DimaFantasy/LPP/(list of files, drawings)

Other design files:
PCB/LPP_Carriage_Module_Gen_1 Ver_2.dip
PCB/LPP_Carriage_Module_Gen_1_Ver_2.dch
PCB/LPP_MainBoard_Gen_1_Ver_5.dch
PCB/LPP_MainBoard_Gen_1_Ver_5.dip
