DimaFantasy/LPP/LPP_STM32F103C8Tx/Core/Src/main.c

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
/* Includes ------------------------------------------------------------------*/
#include "main.h"
#include "usb_device.h"

/* USER CODE BEGIN Includes */
#include <math.h>
#include <stdbool.h>
#include "counter.h"
#include "stdio.h"

#include "lpp_sdk.h"
/* USER CODE END Includes */

/* USER CODE BEGIN PM */

// ============================================================================
// Сигнатура и версия прошивки (APP)
// ============================================================================
const uint32_t APP_KEY0   __attribute__((section(APP_KEY0_SECTION)))   = APP_SIG_KEY0;
const uint32_t APP_KEY1   __attribute__((section(APP_KEY1_SECTION)))   = APP_SIG_KEY1;
const uint32_t APP_KEY2   __attribute__((section(APP_KEY2_SECTION)))   = APP_SIG_KEY2;
const uint32_t APP_KEY3   __attribute__((section(APP_KEY3_SECTION)))   = APP_SIG_KEY3;

const uint32_t APP_VER_F  __attribute__((section(APP_VER_F_SECTION)))  = APP_VERSION;

// Глобальные определения таймеров и режимов
TIM_HandleTypeDef htim1;
TIM_HandleTypeDef htim2;

/* USER CODE END PM */

TIM_HandleTypeDef htim3;
TIM_HandleTypeDef htim4;

/* USER CODE BEGIN PV */

void XferCpltCallback(DMA_HandleTypeDef *hdma);

// ============================================================================
// Внешние объявления
// ============================================================================

extern uint8_t USBD_CUSTOM_HID_SendReport(USBD_HandleTypeDef* pdev, uint8_t* report, uint16_t len);
extern USBD_HandleTypeDef hUsbDeviceFS;

/* USER CODE END PV */

void SystemClock_Config(void);
static void MX_GPIO_Init(void);
static void MX_TIM3_Init(void);
static void MX_TIM4_Init(void);
/* USER CODE BEGIN PFP */
static void DMA_M2M_Init();
/* USER CODE END PFP */

/* USER CODE BEGIN 0 */
static uint8_t enc_b_state = 0;
/* USER CODE END 0 */

/**
  * @brief  The application entry point.
  * @retval int
  */
int main(void)
{

  /* USER CODE BEGIN 1 */
    // Приоритет 0: EXTI (Энкодер)        — Ловит физический шаг.
    // Приоритет 1: TIM3 (Интерполяция)   — Рассчитывает момент внутри шага.
    // Приоритет 2: DMA (PWM Laser)        — DMA, который «включает порт».
    // Приоритет 3: DMA1_CH1 (M2M Data)   — Перекачка данных из буфера.
    // Приоритет 4: TIM2 (ШИМ мотора X)   — Степпер X.
    // Приоритет 5: TIM4 (ось Y, шаговый) — Степпер Y.
    // Приоритет 6: USB                   — Связь.
  /* USER CODE END 1 */

  /* MCU Configuration--------------------------------------------------------*/

  /* Reset of all peripherals, Initializes the Flash interface and the Systick. */
  HAL_Init();

  /* Configure the system clock */
  SystemClock_Config();

  /* Initialize all configured peripherals */
  MX_GPIO_Init();
  MX_USB_DEVICE_Init();
  MX_TIM3_Init();
  MX_TIM4_Init();

  /* USER CODE BEGIN 2 */
    DMA_M2M_Init();

    // ============================================================
    // ЯВНАЯ РАССТАНОВКА ПРИОРИТЕТОВ ПРЕРЫВАНИЙ
    // Меньше число = выше приоритет
    // ============================================================

    // 0: EXTI (энкодер) — самый критичный, ловит физический шаг
    HAL_NVIC_SetPriority(EXTI0_IRQn,      0, 0);
    HAL_NVIC_SetPriority(EXTI1_IRQn,      0, 0);
    HAL_NVIC_SetPriority(EXTI2_IRQn,      0, 0);
    HAL_NVIC_SetPriority(EXTI3_IRQn,      0, 0);
    HAL_NVIC_SetPriority(EXTI4_IRQn,      0, 0);
    HAL_NVIC_SetPriority(EXTI9_5_IRQn,    0, 0);
    HAL_NVIC_SetPriority(EXTI15_10_IRQn,  0, 0);

    // 1: TIM3 (интерполяция лазера)
    HAL_NVIC_SetPriority(TIM3_IRQn, 1, 0);

    // 3: DMA1_CH1 (M2M копирование данных печати)
    HAL_NVIC_SetPriority(DMA1_Channel1_IRQn, 3, 0);
    HAL_NVIC_EnableIRQ(DMA1_Channel1_IRQn);

    // 4: TIM2 (ШИМ/шаг мотора X)
    HAL_NVIC_SetPriority(TIM2_IRQn, 4, 0);

    // 5: TIM4 (ось Y, шаговый)
    HAL_NVIC_SetPriority(TIM4_IRQn, 5, 0);
    HAL_NVIC_EnableIRQ(TIM4_IRQn);

    // 6: USB
    HAL_NVIC_SetPriority(USB_LP_CAN1_RX0_IRQn, 6, 0);
    HAL_NVIC_SetPriority(USB_HP_CAN1_TX_IRQn,  6, 0);
    HAL_NVIC_SetPriority(USBWakeUp_IRQn,        6, 0);

    // Инициализация SDK (после расстановки приоритетов)
    Lpp_Init();

    // Запуск TIM4 (ось Y)
    HAL_TIM_Base_Start_IT(&htim4);

    // Инициализация USB с аппаратным реконнектом
#if defined(STM32F401xE) || defined(STM32F401xC) || \
        defined(STM32F411xE)
    USB_OTG_FS->GCCFG &= ~USB_OTG_GCCFG_PWRDWN;
    HAL_Delay(10);
#elif defined(STM32G431xx)
    USB->BCDR &= ~USB_BCDR_DPPU;
    HAL_Delay(10);
#endif

    F_RESET_PIN(&g_pins[SYS_PIN_USB_EN]);
    HAL_Delay(2000);

    F_SET_PIN(&g_pins[SYS_PIN_USB_EN]);
    HAL_Delay(50);

#if defined(STM32F401xE) || defined(STM32F401xC) || \
        defined(STM32F411xE)
    USB_OTG_FS->GCCFG |= USB_OTG_GCCFG_PWRDWN;
#elif defined(STM32G431xx)
    USB->BCDR |= USB_BCDR_DPPU;
#endif

  /* USER CODE END 2 */

  /* Infinite loop */
  /* USER CODE BEGIN WHILE */
    while (1) {
    /* USER CODE END WHILE */

    /* USER CODE BEGIN 3 */
        Lpp_MainLoop();
    }
  /* USER CODE END 3 */
}

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
/* USER CODE BEGIN 4 */

/**
 ******************************************************************************
 * @file    lpp_sdk_f103.c
 * @brief   Реализация аппаратного уровня LPP для STM32F103 (Blue Pill)
 ******************************************************************************
 */

// Глобальные переменные SDK
volatile uint32_t dma_pwm_masks[1][2] = {0}; // [Laser][SET, RESET]
uint32_t raw_pin_masks[1] = {0};             // Маска пина лазера
uint32_t LAST_LASER_FREQ = 0;
volatile int32_t X_PWM_CURRENT = 0;

// ============================================================================
// СЕКЦИЯ: СВЯЗЬ (USB HID)
// ============================================================================

uint8_t PacketSend(uint8_t* buffer) {
    return USBD_CUSTOM_HID_SendReport(&hUsbDeviceFS, buffer, 64);
}

// ============================================================================
// СЕКЦИЯ: МОТОР ОСИ X (TIM2) — STM32F103 @ 72МГц
// ============================================================================

__STATIC_INLINE void X_PWM_SET(void) {
    if (W_X_POL_PWM == 0) F_SET_PIN(&g_pins[PIN_X_MO_L]);
    else                   F_RESET_PIN(&g_pins[PIN_X_MO_L]);
}

__STATIC_INLINE void X_PWM_CLR(void) {
    if (W_X_POL_PWM == 0) F_RESET_PIN(&g_pins[PIN_X_MO_L]);
    else                   F_SET_PIN(&g_pins[PIN_X_MO_L]);
}

__STATIC_INLINE void X_DIR_SET(void) {
    if (W_X_POL_DIR == 0) F_SET_PIN(&g_pins[PIN_X_MO_R]);
    else                   F_RESET_PIN(&g_pins[PIN_X_MO_R]);
}

__STATIC_INLINE void X_DIR_CLR(void) {
    if (W_X_POL_DIR == 0) F_RESET_PIN(&g_pins[PIN_X_MO_R]);
    else                   F_SET_PIN(&g_pins[PIN_X_MO_R]);
}

void XMotorInit(X_MOTOR_MODE_T mode) {
    if (X_MOTOR_MODE == mode) return;

    HAL_NVIC_DisableIRQ(TIM2_IRQn);
    HAL_NVIC_ClearPendingIRQ(TIM2_IRQn);

    __HAL_RCC_TIM2_FORCE_RESET();
    __HAL_RCC_TIM2_RELEASE_RESET();
    __HAL_RCC_TIM2_CLK_ENABLE();

    TIM2->CR1  = 0;
    TIM2->CR2  = 0;
    TIM2->DIER = 0;
    TIM2->SR   = 0;
    TIM2->CCER = 0;
    X_PWM_CURRENT = 0;

    htim2.Instance               = TIM2;
    htim2.Init.CounterMode       = TIM_COUNTERMODE_UP;
    htim2.Init.ClockDivision     = TIM_CLOCKDIVISION_DIV1;
    htim2.Init.AutoReloadPreload = TIM_AUTORELOAD_PRELOAD_ENABLE;

    if (mode == X_MOTOR_MODE_STEP) {
        // 72МГц / 72 = 1МГц → 1 тик = 1 мкс
        htim2.Init.Prescaler = 71;
        htim2.Init.Period    = 10000;

        HAL_TIM_OnePulse_Init(&htim2, TIM_OPMODE_SINGLE);

        TIM2->DIER = 0;
        TIM2->EGR |= TIM_EGR_UG;
        TIM2->SR   = 0;
        TIM2->DIER |= TIM_DIER_UIE;

        // STEP-режим: приоритет 4 (выше чем PWM)
        HAL_NVIC_SetPriority(TIM2_IRQn, 4, 0);
        HAL_NVIC_EnableIRQ(TIM2_IRQn);

        TIM2->ARR  = 100;
        TIM2->CNT  = 0;
        TIM2->SR   = 0;
        TIM2->CR1 |= TIM_CR1_CEN;
    }
    else {
        // 72МГц / 14 ≈ 5.14МГц, период 5001 тик ≈ ~1кГц ШИМ
        htim2.Init.Prescaler = 13;
        htim2.Init.Period    = 5001;
        HAL_TIM_Base_Init(&htim2);

        TIM2->CR1 &= ~TIM_CR1_OPM;

        TIM_OC_InitTypeDef sConfigOC = {0};
        sConfigOC.OCMode = TIM_OCMODE_TIMING;
        sConfigOC.Pulse  = 2500;
        HAL_TIM_OC_ConfigChannel(&htim2, &sConfigOC, TIM_CHANNEL_1);

        TIM2->CR1   |= TIM_CR1_ARPE;
        TIM2->CCMR1 |= TIM_CCMR1_OC1PE;

        TIM2->DIER = 0;
        TIM2->EGR |= TIM_EGR_UG;
        TIM2->SR   = 0;
        TIM2->DIER |= TIM_DIER_UIE | TIM_DIER_CC1IE;

        // PWM-режим: приоритет 5 (ниже STEP, не вытесняет TIM4 Y-оси)
        // ИСПРАВЛЕНИЕ: изменён с 5 на 4, чтобы соответствовать таблице приоритетов.
        // TIM4 (Y-ось) имеет приоритет 5 — TIM2 в PWM режиме не должен быть ниже.
        HAL_NVIC_SetPriority(TIM2_IRQn, 4, 0);
        HAL_NVIC_EnableIRQ(TIM2_IRQn);

        TIM2->CR1 |= TIM_CR1_CEN;
    }

    X_MOTOR_MODE = mode;
}

/**
 * @brief Программная задержка dead-time между переключением ключей моста
 */
__STATIC_INLINE void XMotorDeadTime(void) {
    for (volatile int i = 0; i < 50; i++) { __NOP(); }
}

static volatile uint8_t X_DIR_NEXT = 0;

void TIM2_IRQHandler(void) {
    uint32_t sr = TIM2->SR;

    if (sr & TIM_SR_UIF) {
        TIM2->SR = ~TIM_SR_UIF;

        XTimerCallback();

        if (X_MOTOR_MODE != X_MOTOR_MODE_STEP) {

            F_RESET_PIN(&g_pins[PIN_X_MO_L]);
            F_RESET_PIN(&g_pins[PIN_X_MO_L_H]);
            F_RESET_PIN(&g_pins[PIN_X_MO_R_H]);
            if (X_MOTOR_MODE == X_MOTOR_MODE_TWO_PWM) {
                F_RESET_PIN(&g_pins[PIN_X_MO_R]);
            }

            if (X_PWM_CURRENT != 0) {
                XMotorDeadTime();

                if (X_MOTOR_MODE == X_MOTOR_MODE_TWO_PWM) {
                    uint32_t abs_pwr = (uint32_t)abs(X_PWM_CURRENT);
                    if (abs_pwr > 4900) abs_pwr = 4900;
                    TIM2->CCR1 = abs_pwr;

                    uint8_t fwd = (X_PWM_CURRENT > 0) ? 1 : 0;
                    if (W_X_POL_PWM) fwd = !fwd;

                    if (fwd) {
                        F_SET_PIN(&g_pins[PIN_X_MO_L]);
                        F_SET_PIN(&g_pins[PIN_X_MO_R_H]);
                    } else {
                        F_SET_PIN(&g_pins[PIN_X_MO_R]);
                        F_SET_PIN(&g_pins[PIN_X_MO_L_H]);
                    }
                }
                else if (X_MOTOR_MODE == X_MOTOR_MODE_ONE_PWM) {
                    uint32_t abs_pwr = (uint32_t)abs(X_PWM_CURRENT);
                    if (abs_pwr > 4900) abs_pwr = 4900;
                    TIM2->CCR1 = abs_pwr;
                    X_PWM_SET();
                }
            }
        }
    }

    if (sr & TIM_SR_CC1IF) {
        TIM2->SR = ~TIM_SR_CC1IF;

        if (X_MOTOR_MODE == X_MOTOR_MODE_TWO_PWM) {
            F_RESET_PIN(&g_pins[PIN_X_MO_L]);
            F_RESET_PIN(&g_pins[PIN_X_MO_R]);
            F_RESET_PIN(&g_pins[PIN_X_MO_L_H]);
            F_RESET_PIN(&g_pins[PIN_X_MO_R_H]);
        }
        else if (X_MOTOR_MODE == X_MOTOR_MODE_ONE_PWM) {
            X_PWM_CLR();

            X_DIR_NEXT = (X_PWM_CURRENT >= 0) ? 0 : 1;
            if (X_DIR_NEXT) X_DIR_SET();
            else            X_DIR_CLR();
        }
    }
}

void XTimerSet(uint16_t period) {
    if (X_MOTOR_MODE == X_MOTOR_MODE_STEP) {
        TIM2->ARR  = period;
        TIM2->CNT  = 0;
        TIM2->SR   = 0;
        TIM2->CR1 |= TIM_CR1_CEN;
    }
}

// Потолок 4850 вместо ARR=5001: запас нужен, т.к. CCR1
// пишется в конце ISR (после XTimerCallback+DeadTime), и при
// power близком к ARR счётчик CNT успевает обогнать запись CCR1 —
// CC1 не срабатывает, период проходит с выходом в 0.
// На F103 (72МГц, IRQ-приоритет делится с TIM4) запас взят больше,
// чем на G431, т.к. ISR относительно медленнее по тактам.
void XMotorSet(int power) {
    if (X_MOTOR_MODE == X_MOTOR_MODE_STEP) return;

    if (abs(power) < 10) power = 0;
    if (power >  4900) power =  4900;
    if (power < -4900) power = -4900;

    X_PWM_CURRENT = power;

    if (power == 0) {
        TIM2->CCR1 = 0;
        F_RESET_PIN(&g_pins[PIN_X_MO_L_H]);
        F_RESET_PIN(&g_pins[PIN_X_MO_R_H]);
        X_DIR_CLR();
        X_PWM_CLR();
        X_DIR_NEXT = 0;
    } else {
        TIM2->CCR1 = (uint32_t)abs(power);
    }
}

// ============================================================================
// СЕКЦИЯ: ЛАЗЕР И ПОДСВЕТКА (TIM1 + DMA1)
// ============================================================================

void PWM_LaserLight_LinkHardware(void) {
    PIN_CFG_T *laser = &g_pins[PIN_PWM_LASER];

    DMA1_Channel5->CCR &= ~DMA_CCR_EN;
    DMA1_Channel2->CCR &= ~DMA_CCR_EN;

    if (laser->used) F_RESET_PIN(laser);

    DMA1->IFCR = DMA_IFCR_CGIF2 | DMA_IFCR_CGIF5;

    uint32_t ccr_base = DMA_CCR_DIR | DMA_CCR_CIRC | DMA_CCR_MSIZE_1 |
                        DMA_CCR_PSIZE_1 | DMA_CCR_PL_Msk;

    if (laser->used && laser->bsrr != &GPIO_NULL_REG) {
        raw_pin_masks[0] = laser->pin;
        DMA1_Channel5->CPAR  = (uint32_t)laser->bsrr;
        DMA1_Channel5->CMAR  = (uint32_t)&dma_pwm_masks[0][0];
        DMA1_Channel5->CNDTR = 1;
        DMA1_Channel5->CCR   = ccr_base | DMA_CCR_EN;

        DMA1_Channel2->CPAR  = (uint32_t)laser->bsrr;
        DMA1_Channel2->CMAR  = (uint32_t)&dma_pwm_masks[0][1];
        DMA1_Channel2->CNDTR = 1;
        DMA1_Channel2->CCR   = ccr_base | DMA_CCR_EN;
    }
}

void SetLaserLightPWMFrequency(uint32_t freq_hz) {
    if (freq_hz == LAST_LASER_FREQ && freq_hz != 0) return;

    if (freq_hz == 0) {
        TIM1->CR1 &= ~TIM_CR1_CEN;
        LAST_LASER_FREQ = 0;
        return;
    }

    __HAL_RCC_TIM1_CLK_ENABLE();
    __HAL_RCC_DMA1_CLK_ENABLE();

    uint32_t pclk2   = HAL_RCC_GetPCLK2Freq();
    uint32_t tim_clk = ((RCC->CFGR & RCC_CFGR_PPRE2) != RCC_CFGR_PPRE2_DIV1)
                       ? pclk2 * 2 : pclk2;

    uint32_t arr = tim_clk / freq_hz;
    uint32_t psc = 0;

    if (arr > 65535) {
        psc = arr / 65535;
        arr = tim_clk / ((psc + 1) * freq_hz);
    }

    if (arr < 1) arr = 1;
    if (arr > 65535) arr = 65535;

    TIM1->CR1  &= ~TIM_CR1_CEN;
    TIM1->PSC   = psc;
    TIM1->ARR   = arr - 1;
    TIM1->CCR1  = 0;
    TIM1->DIER  = TIM_DIER_UDE | TIM_DIER_CC1DE;

    PWM_LaserLight_LinkHardware();

    TIM1->BDTR |= TIM_BDTR_MOE;
    TIM1->EGR  |= TIM_EGR_UG;
    TIM1->SR    = 0;
    TIM1->CR1  |= TIM_CR1_CEN;

    LAST_LASER_FREQ = freq_hz;
}

void Laser_Off(void) {
    LASER_SAFETY_LOCK = 1;
    HAL_TIM_Base_Stop_IT(&htim3);
    SetLaserPWM(0);
    TIM1->EGR |= TIM_EGR_UG;
    F_RESET_PIN(&g_pins[PIN_PWM_LASER]);
}

void Laser_Ready(void) {
    TIM3->CNT = 0;
    TIM1->CNT = 0;
    TIM1->EGR |= TIM_EGR_UG;
    LASER_SAFETY_LOCK = 0;
}

inline void SetLaserPWM(uint16_t val) {
    if (LASER_SAFETY_LOCK) val = 0;
    if (val > 1000) val = 1000;
    uint32_t arr = TIM1->ARR;
    uint32_t ccr = ((uint32_t)val * arr) / 1000;

    dma_pwm_masks[0][0] = (val > 0)    ? raw_pin_masks[0]         : 0;
    dma_pwm_masks[0][1] = (val < 1000) ? (raw_pin_masks[0] << 16) : 0;
    TIM1->CCR1 = ccr;

    if (val == 0) F_RESET_PIN(&g_pins[PIN_PWM_LASER]);
}

// ============================================================================
// СЕКЦИЯ: DMA M2M (Копирование пакетов)
// ============================================================================

void DMA_M2M_Init(void) {
    __HAL_RCC_DMA1_CLK_ENABLE();
}

void FIFO_DATA_StartDma(uint32_t src, uint32_t dst, uint16_t count) {
    DMA1_Channel1->CCR &= ~DMA_CCR_EN;
    DMA1->IFCR = DMA_IFCR_CGIF1;

    DMA1_Channel1->CPAR  = src;
    DMA1_Channel1->CMAR  = dst;
    DMA1_Channel1->CNDTR = count;

    // M2M, Low Priority, 8-bit, MINC, PINC, TCIE, TEIE
    DMA1_Channel1->CCR = DMA_CCR_MEM2MEM | DMA_CCR_MINC | DMA_CCR_PINC |
                         DMA_CCR_TCIE | DMA_CCR_TEIE | DMA_CCR_EN;
}

void DMA1_Channel1_IRQHandler(void) {
    if (DMA1->ISR & DMA_ISR_TCIF1) {
        DMA1->IFCR = DMA_IFCR_CTCIF1;
        FIFO_DATA_EndDma();
    }
}

// ============================================================================
// СЕКЦИЯ: ИНТЕРПОЛЯЦИЯ И Y-ОСЬ
// ============================================================================

void HAL_TIM_PeriodElapsedCallback(TIM_HandleTypeDef* htim) {
    if (htim->Instance == TIM3) {
        if (XInterpTimerCallback() == 0) {
            HAL_TIM_Base_Stop_IT(&htim3);
            TIM3->CNT = 0;
        }
    }
    if (htim->Instance == TIM4) {
        YTimerCallback();
    }
}

void YTimerSet(uint16_t period) {
    __HAL_TIM_SET_AUTORELOAD(&htim4, period);
    __HAL_TIM_ENABLE(&htim4);
}

void XInterpTimerStart(uint32_t period) {
    HAL_NVIC_EnableIRQ(TIM3_IRQn);
    TIM3->ARR = period;
    TIM3->SR &= ~TIM_SR_UIF;
    TIM3->DIER |= TIM_DIER_UIE;
    TIM3->CR1 |= TIM_CR1_CEN;
}

// ============================================================================
// ОБРАБОТЧИКИ ПРЕРЫВАНИЙ EXTI (Энкодер)
// ============================================================================

void LPP_GPIO_EXTI_Handler(uint16_t pin_mask) {
    XEncoderCallback(pin_mask);
}

void EXTI0_IRQHandler(void)  { __HAL_GPIO_EXTI_CLEAR_IT(GPIO_PIN_0);  LPP_GPIO_EXTI_Handler(GPIO_PIN_0);  }
void EXTI1_IRQHandler(void)  { __HAL_GPIO_EXTI_CLEAR_IT(GPIO_PIN_1);  LPP_GPIO_EXTI_Handler(GPIO_PIN_1);  }
void EXTI2_IRQHandler(void)  { __HAL_GPIO_EXTI_CLEAR_IT(GPIO_PIN_2);  LPP_GPIO_EXTI_Handler(GPIO_PIN_2);  }
void EXTI3_IRQHandler(void)  { __HAL_GPIO_EXTI_CLEAR_IT(GPIO_PIN_3);  LPP_GPIO_EXTI_Handler(GPIO_PIN_3);  }
void EXTI4_IRQHandler(void)  { __HAL_GPIO_EXTI_CLEAR_IT(GPIO_PIN_4);  LPP_GPIO_EXTI_Handler(GPIO_PIN_4);  }

void EXTI9_5_IRQHandler(void) {
    uint32_t pin = EXTI->PR & 0x03E0;
    __HAL_GPIO_EXTI_CLEAR_IT(pin);
    LPP_GPIO_EXTI_Handler((uint16_t)pin);
}

void EXTI15_10_IRQHandler(void) {
    uint32_t pin = EXTI->PR & 0xFC00;
    __HAL_GPIO_EXTI_CLEAR_IT(pin);
    LPP_GPIO_EXTI_Handler((uint16_t)pin);
}

/* USER CODE END 4 */
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
