DimaFantasy/LPP/LPP_SDK/lpp_sdk.c

/**
 ******************************************************************************
 * @file    lpp_sdk.c
 * @brief   Laser Printer Platform (LPP) — SDK core definitions
 *
 * This file is part of the LPP (Laser Printer Platform) SDK —
 * a software development kit for embedded laser printer control,
 * designed for STM32 microcontrollers (Blue Pill, Black Pill, G4 series).
 *
 * Copyright (C) 2025  Dima
 *
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
 * Official channel: https://t.me/LPP_Printer
 * Community chat:    https://t.me/LPP_Printer_Chat
 ******************************************************************************
 */

#include "lpp_sdk.h"
#include <string.h>  

// ============================================================================
// ВНУТРЕННИЕ ПРОТОТИПЫ (Internal SDK Prototypes)
// Объявлены здесь для видимости внутри lpp_sdk.c
// ============================================================================

void XSetStep(uint8_t state);
void XSetDir(uint8_t state);
void XSetEnableStepper(uint8_t state);
void XSetEnableDCBLDC(uint8_t state);
void XMotorSet(int power);

void YSetStep(uint8_t state);
void YSetDir(uint8_t state);
void YSetEnable(uint8_t state);

void Hardware_Init_System_Pins();
// ============================================================================
// Переменные управления осью X
// ============================================================================

// Параметры управления движением по X

volatile int32_t W_X_SPEED_ERROR_INTEGRAL = 0;  // Накопленная интегральная ошибка
volatile int32_t W_X_SPEED_SET_POLAR;           // Скорость со знаком
volatile int32_t W_X_P_component;               // Пропорциональная составляющая
volatile int32_t W_X_I_component;               // Интегральная составляющая
volatile int32_t W_X_PI_sum;                    // Сумма P+I составляющих

volatile uint8_t needSendStatusReport = 0;  // Флаг необходимости отправки статуса

// Яркость подсветки — управляется из SetLight1/2PWM, читается в Lpp_MainLoop
volatile uint16_t led1_pwm_val = 0;
volatile uint16_t led2_pwm_val = 0;

// @brief Установка яркости подсветки LED1 (0..100)
void SetLight1PWM(uint16_t val) {
    if (val > 100) val = 100;
    led1_pwm_val = val;
    if (val == 0) F_RESET_PIN(&g_pins[PIN_PWM_LED1]);
}

// @brief Установка яркости подсветки LED2 (0..100)
void SetLight2PWM(uint16_t val) {
    if (val > 100) val = 100;
    led2_pwm_val = val;
    if (val == 0) F_RESET_PIN(&g_pins[PIN_PWM_LED2]);
}

// Глобальные переменные для управления печатью
volatile uint8_t CURRENT_PRINT_DIRECTION = 0;  // 0-слева направо, 1-справа налево
volatile int32_t PRINT_LEFT_BORDER = 0;        // Левая граница зоны печати
volatile int32_t PRINT_RIGHT_BORDER = 0;       // Правая граница зоны пепати

// ============================================================================
// БЕЗОПАСНАЯ ОСТАНОВКА И СМЕНА НАПРАВЛЕНИЯ ДЛЯ ШАГОВОГО МОТОРА
// ============================================================================

volatile uint8_t X_STOPPING = 0;         // Флаг процесса остановки
volatile uint8_t X_TRACKING_ACTIVE = 0;  // Флаг активного трекинга

// ============================================================================
// Буферы для двойной буферизации данных печати
// ============================================================================

#define INTERPOL_MAX 4                           // Максимальный коэффициент интерполяции (X4)
volatile uint8_t nextPrintBit[2][INTERPOL_MAX];  // Двойной буфер для предварительно прочитанных битов
volatile uint8_t activeBuffer = 0;               // Активный буфер (читается таймером)
volatile uint8_t NextBuffer = 1;                 // Следующий буфер (заполняется данными)

// ============================================================================
// Переменные управления системой
// ============================================================================

// Переменные для интерполяции энкодера
volatile uint8_t INTERPOL_X = 1;      // Коэффициент интерполяции X (2 = кратное увеличение разрешения)
volatile uint8_t interp_counter = 0;  // Счетчик интерполированных импульсов
volatile uint32_t interp_period;      // Период интерполяции

// ============================================================================
// Основные структуры конфигурации
// ============================================================================

TYPE_PRINT_CONFIG PRINT_CONFIG = {0};
TYPE_PRINT_DATA PRINT_DATA = {0};
TYPE_USB_TUNING_X USB_TUNING_X = {0};
TYPE_USB_TUNING_Y USB_TUNING_Y = {0};
TYPE_APP_RESET APP_RESET = {0};
TYPE_TRACK TRACK = {0};
TYPE_LPP_ID LPP_ID = {0};
TYPE_SET_X SET_X = {0};
TYPE_SET_Y SET_Y = {0};
TYPE_SET_PARAM SET_PARAM = {0};
TYPE_LIGHT LIGHT = {0};
TYPE_LAZER LAZER = {0};
TYPE_APP_JAMP_TO_BOOT APP_JAMP_TO_BOOT = {0};
TYPE_APP_SPEED_TEST APP_SPEED_TEST = {0};
TYPE_APP_WRITE APP_WRITE = {0};
TYPE_APP_ERASE APP_ERASE = {0};
TYPE_APP_ID APP_ID = {0};
TYPE_SPEED_TEST SPEED_TEST = {0};

// ============================================================================
// ПЕРЕМЕННЫЕ УПРАВЛЕНИЯ ОСЬЮ X
// ============================================================================

// ----------------------------------------------------
// Параметры управления движением по X
// ----------------------------------------------------
volatile int16_t W_X_POWER_REAL = 0;      // Реальная мощность на моторе
volatile int8_t W_X_EN_DIRECT = 0;        // Направление движения каретки
volatile uint16_t W_X_SPEED_SET = 1000;   // Заданная скорость движения
volatile int32_t W_X_SPEED_FILTERED = 0;  // Скорость с учётом направления
volatile uint16_t W_X_POWER_MAX = 500;    // Максимальная мощность
volatile uint16_t W_X_SPEED = 0;          // Скорость в тиках счетчика
volatile int32_t W_X_SPEED_ERROR = 0;     // Ошибка скорости

// ----------------------------------------------------
// PID коэффициенты для стабилизации скорости
// ----------------------------------------------------
volatile uint16_t X_KP = 0;  // Пропорциональный коэффициент
volatile uint16_t X_KI = 0;  // Интегральный коэффициент

volatile uint16_t X_KP_POS = 0;  // Пропорциональный коэффициент при позиционировании

// ============================================================================
// Переменные управления положением X
// ============================================================================

X_MOTOR_MODE_T X_MOTOR_MODE = X_MOTOR_MODE_START;  // Режим работы мотора
volatile int32_t X_GO_POS = 0;                     // Целевая позиция каретки
volatile int32_t X_POS = 0;                        // Текущая позиция каретки

volatile uint8_t X_POLAR_DYNAMIC = 0;  // Полярность при движении/треке

// Полярность управления мотором
volatile uint8_t W_X_POL_DIR = 0;  // Полярность направления
volatile uint8_t W_X_POL_PWM = 0;  // Полярность ШИМ
volatile uint8_t W_X_POL_EN = 0;  // Полярность энкодера

// ============================================================================
// Переменные для режима STEP (шаговый мотор)
// ============================================================================

volatile int32_t X_START_POS = 0;   // Начальная позиция
volatile int32_t X_HALF_POS = 0;    // Половина пути
volatile uint8_t X_PIN = 0;         // Виртуальный STEP (0/1)
volatile uint16_t X_REAL_SPED = 0;  // Реальная скорость (период таймера)
volatile int16_t X_MIN_POW = 1;     // Минимальная мощность
volatile int16_t X_ACCL = 0;        // Ускорение (длина разгона/торможения)

volatile uint8_t X_DIR_HI = 0;   // Направление X (HIGH)
volatile uint8_t X_DIR_LO = 0;   // Направление X (LOW)
volatile uint8_t X_STEP_HI = 0;  // Шаг X (HIGH)
volatile uint8_t X_STEP_LO = 0;  // Шаг X (LOW)

uint16_t TUNING_X[1000] = {0};  // Массив тюнинга ускорения/торможения

volatile X_MOTION_T X_MOTION = X_MOTION_NONE;  // Текущее направление движения
volatile uint8_t X_RETURN_DONE = 0;            // Флаг завершения возврата



// ============================================================================
// Вспомогательные переменные управления
// ============================================================================
// static int32_t X_ERROR_ACCUM          = 0;			// Накопитель интегральной ошибки для позиционного регулятора
static int32_t X_LAST_POSITION = 0;   // Последняя позиция для расчёта дельты (скорость, залипание)
static int32_t X_POWER_ACCUM = 0;     // Накопление мощности для разблокировки мотора при залипании
static uint32_t X_STUCK_COUNTER = 0;  // Счётчик залипания мотора (увеличивается при отсутствии движения)

// ============================================================================
// ПЕРЕМЕННЫЕ УПРАВЛЕНИЯ ОСЬЮ Y
// ============================================================================

volatile Y_STATUS_T Y_STATUS = Y_STATUS_READY;  // Текущий статус готовности Y
volatile Y_MOTION_T Y_MOTION = Y_MOTION_NONE;   // Текущее направление движения Y

// Позиционные переменные осей
volatile int32_t Y_START_POS = 0;   // Начальная позиция каретки Y
volatile int32_t Y_FINISH_POS = 0;  // Конечная позиция каретки Y
volatile int32_t Y_HALF_POS = 0;    // Половина трека Y
volatile int32_t Y_POS = 0;         // Текущая позиция каретки Y
volatile uint16_t Y_REAL_SPED = 0;  // Реальная скорость Y

// Управление шаговым двигателем Y
volatile uint8_t Y_DIR_HI = 0;   // Направление Y (высокий уровень)
volatile uint8_t Y_DIR_LO = 0;   // Направление Y (низкий уровень)
volatile uint8_t Y_STEP_HI = 0;  // Шаг Y (высокий уровень)
volatile uint8_t Y_STEP_LO = 0;  // Шаг Y (низкий уровень)

volatile int16_t Y_MIN_POW = 1;  // Минимальная мощность Y 
volatile int16_t Y_ACCL = 0;     // Ускорение Y

volatile uint16_t ENCODER_A_PIN = 0;
volatile uint16_t ENCODER_B_PIN = 0;

uint16_t TUNING_Y[1000] = {0};  // Массив тюнинга ускорения/торможения Y

// ============================================================================
// Переменные процесса печати
// ============================================================================

volatile uint8_t START_PRINT = 0;         // Флаг начала печати
volatile uint8_t PRINT_ACTIVE = 0;        // Флаг активности печати
volatile uint8_t PRINT_ACTIVE_COUNT = 0;  // Счетчик проходов до активации печати

volatile uint8_t SetupPrintJob = 0;     // Настройка задания печати
volatile int32_t Y_LINES = 0;           // Число строк
volatile int32_t Y_IMAGE_POSITION = 0;  // Следующая позиция Y для передачи

// Глобальная переменная в main.c
volatile uint8_t LASER_SAFETY_LOCK = 0; //////////////////////////////////////////////////////////////////

// ============================================================================
// Системные переменные
// ============================================================================

volatile uint8_t X_POS_LAST_STATE = 0;  // Последнее состояние энкодера (0...255)
volatile uint8_t Y_PIN = 0;             // Состояние пина Y (1 или 0)

uint32_t LedStatusChangeMS = 0; // Время последнего переключения LED_STATUS

// ============================================================================
// Функции работы с энкодером (DWT-based)
// ============================================================================

static uint32_t last_time_cycles = 0;           // Время последнего импульса в тактах
volatile uint8_t g_encoder_timeout_active = 0;  // Флаг таймаута энкодера

// ============================================================================
// Функции работы с BOOT-флагом (RTC Backup domain)
// ----------------------------------------------------------------------------
// Назначение:
//   Универсальный механизм передачи состояния между APP и BOOT.
//
// Свойства:
//   - Хранит ровно 1 байт в Backup-домене (RTC/BKP)
//   - Сохраняется при программном и аппаратном reset
//   - Теряется при отключении питания (если VBAT не подключён)
//   - Не использует Flash и SRAM
//   - Работает одинаково на STM32F103 / STM32F411 / STM32G431
// ============================================================================

// ============================================================================
// Magic значение для перехода в BOOTloader через RTC backup register
// ============================================================================ 
#define LPP_BOOT_MAGIC 0x42  // произвольное, редко встречающееся значение

void LPP_BootFlag_Write(uint8_t value)
{
    __HAL_RCC_PWR_CLK_ENABLE();
    
    #if defined(STM32F1)
    __HAL_RCC_BKP_CLK_ENABLE();   // Специфично для F103
    #endif

    HAL_PWR_EnableBkUpAccess();

#if defined(STM32F1)
    BKP->DR1 = (uint32_t)value;
#elif defined(STM32F4) || defined(STM32F0) || defined(STM32G0)
    RTC->BKP0R = (uint32_t)value;
#elif defined(STM32G4)
    TAMP->BKP0R = (uint32_t)value;
#else
    #error "Unsupported MCU"
#endif
}

uint8_t LPP_BootFlag_Read(void)
{
    __HAL_RCC_PWR_CLK_ENABLE();

    #if defined(STM32F1)
    __HAL_RCC_BKP_CLK_ENABLE();   // Специфично для F103
    #endif

    HAL_PWR_EnableBkUpAccess();

#if defined(STM32F1)
    return (uint8_t)(BKP->DR1 & 0xFF);
#elif defined(STM32F4) || defined(STM32F0) || defined(STM32G0)
    return (uint8_t)(RTC->BKP0R & 0xFF);
#elif defined(STM32G4)
    return (uint8_t)(TAMP->BKP0R & 0xFF);
#else
    #error "Unsupported MCU"
#endif
}
// ============================================================================
// Проверка cold power-on reset и очистка RTC-флага при необходимости
// ============================================================================ 
static inline void LPP_BootFlag_ColdPowerClear(void)
{
#if defined(STM32F1)
    // F1: читаем RCC->CSR
    if (RCC->CSR & RCC_CSR_PORRSTF) {
        LPP_BootFlag_Write(0x00);
    }
    __HAL_RCC_CLEAR_RESET_FLAGS();
    
#elif defined(STM32F4) 
    // F4: RCC->CSR
    if (RCC->CSR & RCC_CSR_PORRSTF) {
        LPP_BootFlag_Write(0x00);
    }
    __HAL_RCC_CLEAR_RESET_FLAGS();
    
#elif defined(STM32G4)
    // G4: RCC->CSR
    if (RCC->CSR & RCC_CSR_BORRSTF) {  // G4 использует BORRSTF вместо PORRSTF
        LPP_BootFlag_Write(0x00);
    }
    __HAL_RCC_CLEAR_RESET_FLAGS();
    
#else
    #error "Unsupported MCU"
#endif
}


// ============================================================================
// Функции работы с флеш
// ============================================================================

// Определения для разных серий
#if defined(STM32F411xE)
// Функция определения сектора для F411
static uint32_t GET_SECTOR(uint32_t address) {  // Добавьте static
    if (address < 0x08004000) return 0;         // 16KB
    if (address < 0x08008000) return 1;         // 16KB
    if (address < 0x0800C000) return 2;         // 16KB
    if (address < 0x08010000) return 3;         // 16KB
    if (address < 0x08020000) return 4;         // 64KB
    if (address < 0x08040000) return 5;         // 128KB
    if (address < 0x08060000) return 6;         // 128KB
    return 7;                                   // 128KB
}
#endif

void JumpToApplication(uint32_t app_addr) {

    uint32_t JumpAddress;
    typedef void (*pFunction)(void);
    pFunction reset_vector;

    // 1. Отключить все прерывания
    __disable_irq();

    // 2. Деинициализация HAL и периферии
    HAL_DeInit();

    // 3. Отключить SysTick
    SysTick->CTRL = 0;
    SysTick->LOAD = 0;
    SysTick->VAL = 0;

    // 4. Очистить все флаги прерываний
    for (uint8_t i = 0; i < 8; i++) {
        NVIC->ICER[i] = 0xFFFFFFFF;  // Отключить все прерывания
        NVIC->ICPR[i] = 0xFFFFFFFF;  // Очистить pending флаги
    }

    // 5. Барьеры памяти ПЕРЕД переназначением векторов
    __DSB();
    __ISB();

    // 6. Переназначить вектор прерываний
    SCB->VTOR = app_addr;

    // 7. Барьеры памяти ПОСЛЕ переназначения векторов
    __DSB();
    __ISB();

    // 8. Установить MSP
    __set_MSP(*(volatile uint32_t*)app_addr);

    // 9. Получить адрес Reset Handler
    JumpAddress = *(volatile uint32_t*)(app_addr + 4);
    reset_vector = (pFunction)JumpAddress;

    // 10. Включить прерывания и прыгать
    __enable_irq();
    reset_vector();
}

/**
 * @brief  Запись буфера данных во Flash-память
 *
 * Выполняет запись данных во Flash с учётом требований разных серий STM32:
 * STM32F1/F4 — запись 32-битными словами,
 * STM32G4 — запись 64-битными словами с сохранением соседних данных.
 *
 * @param  addr: начальный адрес (выровнен по 4 байтам)
 * @param  data: буфер данных
 * @param  len:  размер данных в байтах
 *
 * @retval  0   — OK
 * @retval -1   — неверные параметры
 * @retval -2   — ошибка записи Flash
 */
int flash_write_buffer(uint32_t addr, const uint8_t* data, uint32_t len) {
    // Проверка входных параметров:
    // адрес должен быть выровнен по 4 байтам,
    // длина не нулевая,
    // указатель данных валиден
    if ((addr & 3) != 0 || (len == 0) || data == NULL) return -1;

    // Разблокируем контроллер Flash для записи
    HAL_FLASH_Unlock();

#if defined(STM32F103xB) || defined(STM32F411xE)

    // STM32F1 / STM32F4:
    // запись производится 32-битными словами (WORD)
    for (uint32_t i = 0; i < len; i += 4) {
        // Формируем 32-битное слово из буфера данных
        uint32_t word = *(uint32_t*)(data + i);

        // Записываем слово во Flash по адресу addr + i
        if (HAL_FLASH_Program(FLASH_TYPEPROGRAM_WORD, addr + i, word) != HAL_OK) {
            // При ошибке сразу блокируем Flash и выходим
            HAL_FLASH_Lock();
            return -2;
        }
    }

#elif defined(STM32G431xx)

    // STM32G4:
    // запись возможна только 64-битными двойными словами (DOUBLEWORD)

    // Конечный адрес записи
    uint32_t end = addr + len;

    // Адрес начала, выровненный по 8 байтам
    uint32_t aligned_start = addr & ~7U;

    // Адрес конца, выровненный по 8 байтам (в большую сторону)
    uint32_t aligned_end = (end + 7) & ~7U;

    // Проходим по Flash блоками по 8 байт
    for (uint32_t a = aligned_start; a < aligned_end; a += 8) {
        // Читаем текущее 64-битное значение из Flash
        uint64_t current = *(volatile uint64_t*)a;

        // Подготавливаем новое значение (изначально текущее)
        uint64_t new_val = current;

        // -------------------------------
        // Младшие 32 бита (адрес a)
        // -------------------------------
        // Если этот участок попадает в диапазон записи —
        // подменяем младшее слово данными из буфера
        if (a >= addr && a < end) {
            uint32_t lo = *(uint32_t*)(data + (a - addr));
            new_val = (new_val & 0xFFFFFFFF00000000ULL) | lo;
        }

        // -------------------------------
        // Старшие 32 бита (адрес a + 4)
        // -------------------------------
        // Аналогично для старшего слова
        if ((a + 4) >= addr && (a + 4) < end) {
            uint32_t hi = *(uint32_t*)(data + (a + 4 - addr));
            new_val = (new_val & 0x00000000FFFFFFFFULL) | ((uint64_t)hi << 32);
        }

        // Если новое значение отличается от текущего —
        // выполняем запись во Flash
        if (new_val != current) {
            if (HAL_FLASH_Program(FLASH_TYPEPROGRAM_DOUBLEWORD, a, new_val) != HAL_OK) {
                // При ошибке блокируем Flash и выходим
                HAL_FLASH_Lock();
                return -2;
            }
        }
    }

#else
#error "Unsupported STM32 series"
#endif

    // Блокируем Flash после завершения записи
    HAL_FLASH_Lock();

    // Успешное завершение
    return 0;
}

/**
 * @brief  Стирает область флеш-памяти
 * @param  start_address: начальный адрес
 * @param  size: размер области в байтах
 * @retval HAL status
 */
int flash_erase_area(uint32_t start_address, uint32_t size) {
    // Проверка адреса
    if (start_address < FLASH_BASE) {
        return HAL_ERROR;
    }

    HAL_FLASH_Unlock();
    uint32_t PageError = 0;
    FLASH_EraseInitTypeDef pEraseInit;
    memset(&pEraseInit, 0, sizeof(pEraseInit));
    uint32_t end_address = start_address + size;

#if defined(STM32F103xB)
    // F103 - страницы по 1КБ
    uint32_t start_page = (start_address - FLASH_BASE) / FLASH_PAGE_SIZE;
    uint32_t end_page = (end_address - FLASH_BASE + FLASH_PAGE_SIZE - 1) / FLASH_PAGE_SIZE;

    pEraseInit.TypeErase = FLASH_TYPEERASE_PAGES;
    pEraseInit.PageAddress = FLASH_BASE + (start_page * FLASH_PAGE_SIZE);
    pEraseInit.NbPages = end_page - start_page;

#elif defined(STM32F411xE)
    // F411 - сектора разного размера
    uint32_t start_sector = GET_SECTOR(start_address);
    uint32_t end_sector = GET_SECTOR(end_address - 1);  // -1 чтобы не выйти за границу

    pEraseInit.TypeErase = FLASH_TYPEERASE_SECTORS;
    pEraseInit.Sector = start_sector;
    pEraseInit.NbSectors = end_sector - start_sector + 1;
    pEraseInit.VoltageRange = FLASH_VOLTAGE_RANGE_3;

#elif defined(STM32G431xx)
    // G431 - страницы по 2КБ
    uint32_t start_page = (start_address - FLASH_BASE) / FLASH_PAGE_SIZE;
    uint32_t end_page = (end_address - 1 - FLASH_BASE) / FLASH_PAGE_SIZE;  // вычитаем 1

    pEraseInit.NbPages = end_page - start_page + 1;
    pEraseInit.TypeErase = FLASH_TYPEERASE_PAGES;
    pEraseInit.Page = start_page;
    pEraseInit.Banks = FLASH_BANK_1;
#endif

    int result = HAL_FLASHEx_Erase(&pEraseInit, &PageError);
    HAL_FLASH_Lock();
    return result;
}

uint32_t flash_read(uint32_t address) { return (*(__IO uint32_t*)address); }

// ============================================================================
// Функции работы с флеш END
// ============================================================================

/**
 * @brief Инициализация счетчика циклов DWT
 * @retval None
 */
void DWT_Init(void) {
    CoreDebug->DEMCR |= CoreDebug_DEMCR_TRCENA_Msk;  // Включаем DWT
    DWT->CYCCNT = 0;                                 // Сброс счетчика
    DWT->CTRL |= DWT_CTRL_CYCCNTENA_Msk;             // Включение счетчика
    last_time_cycles = DWT->CYCCNT;                  // Инициализация базы времени
}

/**
 * @brief Быстрое преобразование тактов в микросекунды (оптимизировано)
 * @param cycles: количество тактов
 * @retval Время в микросекундах
 */
static inline uint32_t CyclesToMicroseconds(uint32_t cycles) {	
#if defined(STM32F103xB)
    return (uint32_t)(((uint64_t)cycles * 3817748427ULL) >> 38);  // 72 MHz:
#elif defined(STM32F411xE)
		// Если частота 96 MHz
    return (uint32_t)(((uint64_t)cycles * 2863311531ULL) >> 38); 
    // Если частота 100 MHz
    // return (uint32_t)(((uint64_t)cycles * 2748779069ULL) >> 38);	
#elif defined(STM32G431xx)
    return (uint32_t)(((uint64_t)cycles * 1616722929ULL) >> 38);  // 170 MHz:
#else
    return (uint32_t)(((uint64_t)cycles * 1000000ULL) / SystemCoreClock);
#endif
}

/**
 * @brief Обновление данных энкодера
 */
void XEncoder_Update(int8_t pos_d) {
    uint32_t now_cycles = DWT->CYCCNT;
    uint32_t elapsed_cycles = now_cycles - last_time_cycles;
    last_time_cycles = now_cycles;

    uint32_t raw_interval = CyclesToMicroseconds(elapsed_cycles);  // ← uint32_t!

    // Проверка таймаута ИЛИ переполнения uint16_t
    if (raw_interval >= ENCODER_TIMEOUT_US) {
        W_X_SPEED = 0xFFFF;
        W_X_EN_DIRECT = 0;
        g_encoder_timeout_active = 1;
        return;
    }

    W_X_SPEED = (uint16_t)raw_interval;  // Безопасное приведение
    W_X_EN_DIRECT = (pos_d > 0) ? 1 : -1;
    g_encoder_timeout_active = 0;
}

/**
 * @brief 1 kHz обработчик для проверки таймаута энкодера
 */
void DWT_1kHz_Handler(void) {
    if (g_encoder_timeout_active) return;

    uint32_t now_cycles = DWT->CYCCNT;
    uint32_t elapsed_cycles = now_cycles - last_time_cycles;

    uint32_t elapsed_us = CyclesToMicroseconds(elapsed_cycles);  // ← uint32_t!

    if (elapsed_us > ENCODER_TIMEOUT_US) {
        g_encoder_timeout_active = 1;
        W_X_SPEED = 0xFFFF;
        W_X_EN_DIRECT = 0;
    }
}

// ============================================================================
// FIFO
// ============================================================================

volatile TYPE_FIFO_POS_Y FIFO_POS_Y = {0};  // Глобальный FIFO для позиций Y
volatile TYPE_FIFO_DATA FIFO_DATA = {0};    // Глобальный FIFO для данных печати

// ============================================================================
// FIFO позиций Y
// ============================================================================

void FifoPosY_Init(void) {
    /// прерывания для атомарной операции
    FIFO_POS_Y.head = 0;   // Сброс индекса головы очереди
    FIFO_POS_Y.tail = 0;   // Сброс индекса хвоста очереди
    FIFO_POS_Y.count = 0;  // Сброс счетчика элементов

    // Очистка массива координат Y
    for (uint32_t i = 0; i < FIFO_POS_Y_SIZE; i++) {
        FIFO_POS_Y.POS_Y[i] = 0;  // Инициализация нулями
    }
}

//uint8_t FifoPosY_Push(volatile int32_t value) {
//    if (FIFO_POS_Y.count >= FIFO_POS_Y_SIZE) {  // Проверка переполнения
//        __enable_irq();                         // Включаем прерывания
//        return 0;                               // Очередь заполнена
//    }

//    FIFO_POS_Y.POS_Y[FIFO_POS_Y.head] = value;                  // Запись значения
//    FIFO_POS_Y.head = (FIFO_POS_Y.head + 1) % FIFO_POS_Y_SIZE;  // Сдвиг головы
//    FIFO_POS_Y.count++;                                         // Увеличение счетчика

//    return 1;  // Успешная запись
//}

/**
 * @brief Добавляет значение координаты Y в FIFO буфер.
 * @param value Значение для записи.
 * @return 1 - успешно, 0 - буфер полон.
 *
 * Примечания:
 * - Функция вызывается из одного места, без параллельного доступа.
 * - Используется быстрая циклическая адресация без оператора '%'.
 */
uint8_t FifoPosY_Push(int32_t value)
{
    // Проверка на переполнение буфера
    if (FIFO_POS_Y.count >= FIFO_POS_Y_SIZE) {
        return 0;
    }

    // Записываем данные и инкрементируем индекс головы
    FIFO_POS_Y.POS_Y[FIFO_POS_Y.head++] = value;

    // Зацикливаем буфер (быстрее чем оператор %)
    if (FIFO_POS_Y.head >= FIFO_POS_Y_SIZE) {
        FIFO_POS_Y.head = 0;
    }

    // Увеличиваем счётчик элементов
    FIFO_POS_Y.count++;

    return 1;
}

/**
 * @brief Извлекает значение координаты Y из FIFO буфера.
 * @param value Указатель для записи извлечённого значения.
 * @return 1 - успешно, 0 - буфер пуст.
 *
 * Примечания:
 * - Функция вызывается из одного места, без параллельного доступа.
 * - Используется быстрая циклическая адресация без оператора '%'.
 */
uint8_t FifoPosY_Pop(volatile int32_t* value)
{
    // Проверка на пустоту FIFO
    if (FIFO_POS_Y.count == 0) {
        return 0;
    }

    // Чтение значения
    *value = FIFO_POS_Y.POS_Y[FIFO_POS_Y.tail++];

    // Зацикливание буфера
    if (FIFO_POS_Y.tail >= FIFO_POS_Y_SIZE) {
        FIFO_POS_Y.tail = 0;
    }

    // Уменьшение счётчика
    FIFO_POS_Y.count--;

    return 1;
}

uint8_t FifoPosY_IsEmpty(void) {
    return (FIFO_POS_Y.count == 0);  // Проверка: очередь пуста
}

uint8_t FifoPosY_IsFull(void) {
    return (FIFO_POS_Y.count >= FIFO_POS_Y_SIZE);  // Проверка: очередь заполнена
}

uint8_t FifoPosY_FreeSpace(void) {
    return (uint8_t)(FIFO_POS_Y_SIZE - FIFO_POS_Y.count);  // Возвращает свободные слоты
}

// ============================================================================
// FIFO данных печати
// ============================================================================

void FifoData_Init(void) {
    FIFO_DATA.head = 0;                         // Сброс индекса головы
    FIFO_DATA.tail = 0;                         // Сброс индекса хвоста
    FIFO_DATA.count = 0;                        // Сброс счетчика элементов
    FIFO_DATA.capacity = FIFO_DATA_QUEUE_SIZE;  // Установка максимальной ёмкости
    FIFO_DATA.totalBitPos = 0;                  // Сброс счетчика бит
    FIFO_DATA.byteIndex = 0;                    // Сброс индекса текущего байта
    FIFO_DATA.currentByte = 0;                  // Сброс текущего байта

    // Очистка всех блоков данных
    for (uint32_t i = 0; i < FIFO_DATA_QUEUE_SIZE; i++) {
        for (uint32_t j = 0; j < FIFO_DATA_BLOCK_SIZE; j++) {
            FIFO_DATA.BLOCKS[i][j] = 0;  // Инициализация нулями
        }
    }
}

uint8_t FifoData_IsEmpty(void) {
    return (FIFO_DATA.count == 0);  // Проверка: очередь пуста
}

uint8_t FifoData_IsFull(void) {
    return (FIFO_DATA.count >= FIFO_DATA.capacity);  // Проверка: очередь заполнена
}

uint8_t FifoData_ReadBit(void) {
    if (FifoData_IsEmpty()) return 0;  // Проверка: FIFO пуст, вернуть 0

    uint16_t fifoHead = FIFO_DATA.head;            // Локальная копия индекса головы
    uint8_t bitIndex = FIFO_DATA.totalBitPos % 8;  // Вычисление текущего бита в байте

    if (bitIndex == 0) {                                    // Если начинается новый байт
        if (FIFO_DATA.byteIndex >= FIFO_DATA_BLOCK_SIZE) {  // Проверка конца блока
            // Переход к следующему блоку данных
            if (FIFO_DATA.count > 0) {                                       // Если есть блоки в FIFO
                FIFO_DATA.head = (FIFO_DATA.head + 1) % FIFO_DATA.capacity;  // Сдвиг головы FIFO
                FIFO_DATA.count--;                                           // Уменьшение счетчика элементов
            }
            FIFO_DATA.byteIndex = 0;  // Сброс индекса байта

            if (FifoData_IsEmpty()) return 1;  // Если FIFO пуст, вернуть 1 (конец данных)
            fifoHead = FIFO_DATA.head;         // Обновление локальной головы
        }

        FIFO_DATA.currentByte = FIFO_DATA.BLOCKS[fifoHead][FIFO_DATA.byteIndex];  // Чтение нового байта
        FIFO_DATA.byteIndex++;                                                    // Увеличение индекса байта
    }

    uint8_t bit = (FIFO_DATA.currentByte >> bitIndex) & 1;  // Извлечение текущего бита
    FIFO_DATA.totalBitPos++;                                // Увеличение общего счетчика бит

    return bit;  // Возврат считанного бита
}

void FifoData_ReadBitReset(void) {
    FIFO_DATA.totalBitPos = 0;  // Сброс счетчика бит
    FIFO_DATA.byteIndex = 0;    // Сброс индекса текущего байта
    interp_counter = 0;         // Сброс интерполяции
    activeBuffer = 0;           // Сброс текущего активного буфера
    NextBuffer = 0;             // Сброс следующего буфера
}

// ============================================================================
// ЗАПУСК ТРЕКИНГА X
// ============================================================================
void XStartTracking(int32_t left_pos, int32_t right_pos) {
    if (X_TRACKING_ACTIVE == 0) {
        X_RETURN_DONE = 0;      // Сброс флага завершения возврата
        X_TRACKING_ACTIVE = 1;  // Активация трекинга
        X_STOPPING = 0;         // Сброс флага остановки
        // Определяем ближайшую границу
        int32_t dist_to_left = (X_POS > left_pos) ? (X_POS - left_pos) : (left_pos - X_POS);
        int32_t dist_to_right = (X_POS > right_pos) ? (X_POS - right_pos) : (right_pos - X_POS);
        // Едем к ближайшей границе
        if (dist_to_left < dist_to_right) {
            X_GO_POS = left_pos;
            X_POLAR_DYNAMIC = 0;  // Движение влево
        } else {
            X_GO_POS = right_pos;
            X_POLAR_DYNAMIC = 1;  // Движение вправо
        }
        // Сброс интегральной составляющей PID
        W_X_SPEED_ERROR_INTEGRAL = 0;
    }
}

// ============================================================================
// БЕЗОПАСНАЯ ОСТАНОВКА ТРЕКИНГА
// ============================================================================
void XStopTracking(void) { 	
    // Проверка в начале функции
    if (X_STOPPING) return;  // Уже в процессе остановки или не активен
    X_STOPPING = 1;          // Начали процес

    X_RETURN_DONE = 0;  // Двинутся к позиции
    // Для DC-мотора (dual PWM) – останавливаем трекинг сразу
    if (X_MOTOR_MODE != X_MOTOR_MODE_STEP) {
        // Деактивируем трекинг
        X_TRACKING_ACTIVE = 0;

        // Обнуляем PID/PI части
        W_X_POWER_REAL = 0;
        W_X_SPEED_ERROR_INTEGRAL = 0;

        // Сбрасываем направление для обоих режимов
        X_POLAR_DYNAMIC = 0;

        // Возврат на заданную позицию после трекинга
        X_GO_POS = SET_X.DAT.W_X_MOV_POS;
    }
}

//// ============================================================================
//// Основной обработчик энкодера по X и логики печати
//// ============================================================================
void XEncoderCallback(uint16_t pin_mask) {
    if (X_MOTOR_MODE == X_MOTOR_MODE_STEP) return;

    uint8_t pinA = F_GET_PIN(&g_pins[PIN_X_ENC_A]);
    uint8_t pinB = F_GET_PIN(&g_pins[PIN_X_ENC_B]);
    uint8_t curr_state = pinB | (pinA << 1);

    static const int8_t increment[16] = {0, -1, 1, 0, 1, 0, 0, -1, -1, 0, 0, 1, 0, 1, -1, 0};
    int8_t pos_delta = increment[curr_state | (X_POS_LAST_STATE << 2)];

    if (pos_delta == 0) return;

    if (W_X_POL_EN) { pos_delta = -pos_delta; }

    X_POS_LAST_STATE = curr_state;
    X_POS += pos_delta;

    XEncoder_Update(pos_delta);

    // --- Старт печати (подготовка первого буфера перед зоной) ---
    if (pos_delta > 0 && PRINT_ACTIVE && X_POS == PRINT_LEFT_BORDER - 1 && CURRENT_PRINT_DIRECTION == 0) {
        PRINT_ACTIVE_COUNT++;
        if (PRINT_ACTIVE_COUNT >= PRINT_ACTIVE_COUNT_THRESHOLD) {
            PRINT_ACTIVE = 0;
            START_PRINT = 1;
            activeBuffer = 0;
            NextBuffer = 0;
            for (uint8_t i = 0; i < INTERPOL_X; i++) {
                nextPrintBit[activeBuffer][i] = FifoData_ReadBit();
            }
            if (FifoPosY_Pop(&Y_FINISH_POS)) {
                Y_IMAGE_POSITION = 0;
            } else {
                PrintStopJob(PRINT_STATUS_END);
                return;
            }
        }
    }

    // --- Основной процесс печати ---
    if (START_PRINT) {
        // ПРОВЕРКА ЗОНЫ ПЕЧАТИ
        if (X_POS >= PRINT_LEFT_BORDER && X_POS <= PRINT_RIGHT_BORDER) {
            
            // ВХОД В ЗОНУ: Если лазер заблокирован, делаем "горячий" старт
            if (LASER_SAFETY_LOCK) {
                Laser_Ready(); // Сброс фазы ШИМ и таймера интерполяции
            }

            activeBuffer = NextBuffer;
            
            // Вывод бита (вызовется SetLaserPWM, который уже знает про LASER_SAFETY_LOCK)
            SetLaserPWM(nextPrintBit[activeBuffer][0] ? PRINT_CONFIG.DAT.W_SET_LAZER : 0);

            if (INTERPOL_X > 1) {
                interp_counter = 1;
                XInterpTimerStart(W_X_SPEED / INTERPOL_X);
            }

            NextBuffer = activeBuffer ^ 1;
            for (uint8_t i = 0; i < INTERPOL_X; i++) {
                nextPrintBit[NextBuffer][i] = FifoData_ReadBit();
            }
        } 
        else {
            // ВЫХОД ИЗ ЗОНЫ: Мгновенное гашение аппаратным сбросом
            if (!LASER_SAFETY_LOCK) {
                Laser_Off(); // Чистит "хвосты" DMA и ШИМ
            }
            interp_counter = 0;
        }

        // --- Смена направления (Вправо → Влево) ---
        if ((W_X_EN_DIRECT == 1) && (X_POS > PRINT_RIGHT_BORDER) && (CURRENT_PRINT_DIRECTION == 0)) {
            Laser_Off(); 
            if (FifoPosY_Pop(&Y_FINISH_POS)) {
                Y_IMAGE_POSITION++;
                CURRENT_PRINT_DIRECTION = 1;
            } else {
                PrintStopJob(PRINT_STATUS_END);
                return;
            }
        }

        // --- Смена направления (Влево → Вправо) ---
        if ((W_X_EN_DIRECT == -1) && (X_POS < PRINT_LEFT_BORDER) && (CURRENT_PRINT_DIRECTION == 1)) {
            Laser_Off();
            if (FifoPosY_Pop(&Y_FINISH_POS)) {
                Y_IMAGE_POSITION++;
                CURRENT_PRINT_DIRECTION = 0;
            } else {
                PrintStopJob(PRINT_STATUS_END);
                return;
            }
        }
    }
}

// ============================================================================
// Обработчик печати для STEPPER режима (без энкодера)
// ============================================================================
void XStepperStepCallback(int8_t direction) {
    XEncoder_Update(direction);  // Обновление времени в логике
    // --- Старт печати при достижении левой границы и движении вправо ---
    if (direction > 0 && PRINT_ACTIVE && X_POS == PRINT_LEFT_BORDER - 1 && CURRENT_PRINT_DIRECTION == 0) {
        PRINT_ACTIVE_COUNT++;
        if (PRINT_ACTIVE_COUNT >= PRINT_ACTIVE_COUNT_THRESHOLD) {
            PRINT_ACTIVE = 0;
            START_PRINT = 1;

            activeBuffer = 0;
            NextBuffer = 0;

            // Предзагрузка первого буфера битов
            for (uint8_t i = 0; i < INTERPOL_X; i++) {
                nextPrintBit[activeBuffer][i] = FifoData_ReadBit();
            }

            // Извлечение следующей координаты Y
            if (FifoPosY_Pop(&Y_FINISH_POS)) {
                Y_IMAGE_POSITION = 0;
            } else {
                PrintStopJob(PRINT_STATUS_END);
                return;
            }
        }
    }

    // --- Основной процесс печати ---
    if (START_PRINT) {
        // Проверка нахождения в зоне печати
        if (X_POS >= PRINT_LEFT_BORDER && X_POS <= PRINT_RIGHT_BORDER) {
            activeBuffer = NextBuffer;
					
						if (LASER_SAFETY_LOCK) {
								Laser_Ready(); // Сброс фазы ШИМ и снятие блокировки
						}					

            // Управление лазером по текущему биту
            SetLaserPWM(nextPrintBit[activeBuffer][0] ? PRINT_CONFIG.DAT.W_SET_LAZER : 0);

            // Запуск интерполяции (дробных шагов)
            if (INTERPOL_X > 1) {
                interp_counter = 1;
                XInterpTimerStart(X_REAL_SPED / INTERPOL_X);
            }

            // Подготовка следующего буфера битов
            NextBuffer = activeBuffer ^ 1;
            for (uint8_t i = 0; i < INTERPOL_X; i++) {
                nextPrintBit[NextBuffer][i] = FifoData_ReadBit();
            }
        } else {
            // Вне зоны печати: выключить лазер и сбросить интерполяцию
            SetLaserPWM(0);
						if (!LASER_SAFETY_LOCK) {
								Laser_Off();  // Гарантированное гашение с DMA-очисткой
						}					
            interp_counter = 0;
        }

        // --- Смена направления движения (вправо → влево) ---
        if ((direction > 0) && (X_POS > PRINT_RIGHT_BORDER) && (CURRENT_PRINT_DIRECTION == 0)) {
            SetLaserPWM(0);
            if (FifoPosY_Pop(&Y_FINISH_POS)) {
                Y_IMAGE_POSITION++;
                CURRENT_PRINT_DIRECTION = 1;
            } else {
                PrintStopJob(PRINT_STATUS_END);
                return;
            }
        }

        // --- Смена направления движения (влево → вправо) ---
        if ((direction < 0) && (X_POS < PRINT_LEFT_BORDER) && (CURRENT_PRINT_DIRECTION == 1)) {
            SetLaserPWM(0);
            if (FifoPosY_Pop(&Y_FINISH_POS)) {
                Y_IMAGE_POSITION++;
                CURRENT_PRINT_DIRECTION = 0;
            } else {
                PrintStopJob(PRINT_STATUS_END);
                return;
            }
        }
    }
}

// ============================================================================
// Выполнение одного шага интерполяции
// Возвращает 1 — если серия интерполированных шагов завершена
// ============================================================================
uint8_t XInterpTimerCallback(void) {
		// Выключаем лазер, если X вышел за пределы рабочей области
    if (X_POS < PRINT_LEFT_BORDER || X_POS > PRINT_RIGHT_BORDER) {
        SetLaserPWM(0);  // Вне зоны - гасим лазер
        interp_counter = 0;
        return 1;  // Прерываем интерполяцию
    }		
    // Установка мощности лазера в зависимости от текущего бита
    if (nextPrintBit[activeBuffer][interp_counter]) {
        SetLaserPWM(PRINT_CONFIG.DAT.W_SET_LAZER);
    } else {
        SetLaserPWM(0);
    }
    interp_counter++;  // Переход к следующему биту
    if (interp_counter >= INTERPOL_X) {
        return 1;  // Серия интерполированных шагов завершена
    }
    return 0;  // Продолжаем выполнение серии
}

// ============================================================================
// Остановка задания печати и сброс параметров
// ============================================================================
void PrintStopJob(PRINT_STATUS_T PRINT_STATUS) {
		 // ПЕРВЫМ ДЕЛОМ — безопасность. Гасим лазер мгновенно.
    // Если он уже выключен, Laser_Off просто подтвердит блокировку.
    Laser_Off(); 
		LASER_SAFETY_LOCK = 1; // Запрещаем лазеру включаться    
    SetLaserPWM(0);// Выключение лазера
    // Немедленный сброс флага печати
    PRINT_ACTIVE = 0;       // ← Сбросить активность печати	
    // Сброс активных флагов процесса печати
    START_PRINT = 0;
    SetupPrintJob = 0;

    // БЕЗОПАСНАЯ ОСТАНОВКА ТРЕКИНГА
    XStopTracking();

    // Обновление статуса печати
    PRINT_CONFIG.DAT.R_PRINT_STATUS = PRINT_STATUS;
    needSendStatusReport = 1;
}

// Приём и полная обработка 64-байтного пакета
void PacketReceive(uint8_t* buffer) {
    if (buffer == NULL) return;
    uint8_t event_idx = buffer[0];  // Первый байт — индекс команды
    uint8_t state = 0;              // Не используется в текущей логике, но сохранён для совместимости
    // ============================================================================
    // ОБРАБОТКА ПАКЕТА ДАННЫХ ПЕЧАТИ (IDX_PRINT_DATA)
    // ============================================================================
    if (event_idx == IDX_PRINT_DATA) {
        TYPE_PRINT_DATA* PRINT_DAT =
            (TYPE_PRINT_DATA*)(buffer - 1);  // Смещение на 1 байт (из-за структуры BIN[64])
        // ============================================================================
        // Обработка состояния FIFO данных и запуск DMA для новых данных
        // ============================================================================
        if ((FIFO_DATA.count >= FIFO_DATA.capacity) || (PRINT_DAT->DAT.R_FIFO_FUL == 1)) {
            PRINT_DAT->DAT.R_FIFO_FUL = 1;                  // FIFO не принял данные, пакет нужно повторить
            PRINT_DAT->DAT.R_FIFO_COUNT = FIFO_DATA.count;  // Текущее количество блоков в FIFO
            __enable_irq();
        } else {
            uint16_t next_tail = (FIFO_DATA.tail + 1) % FIFO_DATA.capacity;
            // Передаём
            FIFO_DATA_StartDma((uint32_t)PRINT_DAT->DAT.W_BUFFER, (uint32_t)FIFO_DATA.BLOCKS[FIFO_DATA.tail],
                               sizeof(FIFO_DATA.BLOCKS[0])  // или FIFO_DATA_BLOCK_SIZE, если определено
            );
            PRINT_DAT->DAT.R_FIFO_FUL = 0;  // FIFO принял данные, можно отправлять следующий пакет
            PRINT_DAT->DAT.R_FIFO_COUNT = FIFO_DATA.count;  // Текущее количество блоков в FIFO
        }
        // ============================================================================
        // Обработка FIFO координат Y
        // ============================================================================
        if (PRINT_DAT->DAT.R_FIFO_Y_COUNT == 1) {
            FifoPosY_Push(PRINT_DAT->DAT.W_Y_BUFFER);
        }
        PRINT_DAT->DAT.R_FIFO_Y_COUNT = FifoPosY_FreeSpace();
        // Обновление параметров управления
        PRINT_CONFIG.DAT.W_SET_LAZER = PRINT_DAT->DAT.W_SET_LAZER;
        // Параметры скорости для колектрного
        W_X_SPEED_SET = PRINT_DAT->DAT.W_X_SPEED;
        // Параметры скорости для степпера
        X_MIN_POW = PRINT_DAT->DAT.W_X_SPEED;  // Минимальный период (максимальная скорость)
        // Обратная связь
        PRINT_DAT->DAT.W_X_SPEED = W_X_SPEED;
        PRINT_DAT->DAT.RW_Y_IMAGE_POSITION = Y_IMAGE_POSITION;

        if (PRINT_CONFIG.DAT.R_PRINT_STATUS == PRINT_STATUS_PRINT) {
            PacketSend(PRINT_DAT->BIN);
        }
    }
    // ============================================================================
    // ОБРАБОТКА КОНФИГУРАЦИИ ПЕЧАТИ (IDX_PRINT_CONFIG)
    // ============================================================================
    else if (event_idx == IDX_PRINT_CONFIG) {
        memcpy(PRINT_CONFIG.BIN + 1, buffer, 63);
        if (PRINT_CONFIG.DAT.R_PRINT_STATUS == PRINT_STATUS_PRINT) {
            SetupPrintJob = 1;
        } else if (PRINT_CONFIG.DAT.R_PRINT_STATUS > PRINT_STATUS_PRINT) {
            PrintStopJob(PRINT_CONFIG.DAT.R_PRINT_STATUS);
        }
    }
		
    // ============================================================================
    // ОБРАБОТКА ТЮНИНГА ОСИ X (IDX_USB_TUNING_X)
    // ============================================================================
    else if (event_idx == IDX_USB_TUNING_X) {
        memcpy(USB_TUNING_X.BIN + 1, buffer, 63);
        uint32_t Delitel = ((USB_TUNING_X.DAT.W_ADRES - 1) / 25) * 25;
        // Защита от выхода за границы массива
        if (Delitel < 1000) {
            for (int i = 0; i < 25 && (Delitel + i) < 1000; i++) {
                TUNING_X[Delitel + i] = USB_TUNING_X.DAT.TUNING_X[i];
            }
        }
        PacketSend(USB_TUNING_X.BIN);
    }
    // ============================================================================
    // ОБРАБОТКА ТЮНИНГА ОСИ Y (IDX_USB_TUNING_Y)
    // ============================================================================
    else if (event_idx == IDX_USB_TUNING_Y) {
        memcpy(USB_TUNING_Y.BIN + 1, buffer, 63);
        uint32_t Delitel = ((USB_TUNING_Y.DAT.W_ADRES - 1) / 25) * 25;
        for (int i = 0; i < 25; i++) {
            TUNING_Y[Delitel + i] = USB_TUNING_Y.DAT.TUNING_Y[i];
        }
        PacketSend(USB_TUNING_Y.BIN);
    }
    // ============================================================================
    // СБРОС СИСТЕМЫ (IDX_RESET)
    // ============================================================================
    else if (event_idx == IDX_RESET) {
        HAL_NVIC_SystemReset();
    }
    // ============================================================================
    // ЗАПРОС ИДЕНТИФИКАЦИИ (IDX_APP_ID)
    // ============================================================================
    else if (event_idx == IDX_APP_ID) {
        APP_ID.DAT.R_IDX = IDX_APP_ID;
        APP_ID.DAT.W_CURENT = 0;

        // Чтение BOOT
        uint32_t KEY0 = flash_read(BOOT_SIG_BLOCK_ADDR + 0);
        uint32_t KEY1 = flash_read(BOOT_SIG_BLOCK_ADDR + 4);
        uint32_t KEY2 = flash_read(BOOT_SIG_BLOCK_ADDR + 8);
        uint32_t KEY3 = flash_read(BOOT_SIG_BLOCK_ADDR + 12);
        uint32_t _VER = flash_read(BOOT_SIG_BLOCK_ADDR + 16);

        APP_ID.DAT.W_B_NAME[0] = KEY0;
        APP_ID.DAT.W_B_NAME[1] = KEY1;
        APP_ID.DAT.W_B_NAME[2] = KEY2;
        APP_ID.DAT.W_B_NAME[3] = KEY3;
        APP_ID.DAT.W_B_VER =
            (KEY0 == BOOT_SIG_KEY0 && KEY1 == BOOT_SIG_KEY1 && KEY2 == BOOT_SIG_KEY2 && KEY3 == BOOT_SIG_KEY3)
                ? _VER
                : 0;

        // Чтение APP
        KEY0 = flash_read(APP_SIG_BLOCK_ADDR + 0);   // 0x08007FEC
        KEY1 = flash_read(APP_SIG_BLOCK_ADDR + 4);   // 0x08007FF0
        KEY2 = flash_read(APP_SIG_BLOCK_ADDR + 8);   // 0x08007FF4
        KEY3 = flash_read(APP_SIG_BLOCK_ADDR + 12);  // 0x08007FF8
        _VER = flash_read(APP_SIG_BLOCK_ADDR + 16);  // 0x08007FFC

        APP_ID.DAT.W_A_NAME[0] = KEY0;
        APP_ID.DAT.W_A_NAME[1] = KEY1;
        APP_ID.DAT.W_A_NAME[2] = KEY2;
        APP_ID.DAT.W_A_NAME[3] = KEY3;
        APP_ID.DAT.W_A_VER =
            (KEY0 == APP_SIG_KEY0 && KEY1 == APP_SIG_KEY1 && KEY2 == APP_SIG_KEY2 && KEY3 == APP_SIG_KEY3)
                ? _VER
                : 0;

        // Уникальный ID микроконтроллера
        APP_ID.DAT.W_ID[0] = HAL_GetUIDw0();
        APP_ID.DAT.W_ID[1] = HAL_GetUIDw1();
        APP_ID.DAT.W_ID[2] = HAL_GetUIDw2();
        APP_ID.DAT.ID = 0;

        APP_ID.DAT.W_X_POS = X_POS;
        APP_ID.DAT.W_Y_POS = Y_POS;

        // Отправка данных хосту
        PacketSend(APP_ID.BIN);
    }
    // ============================================================================
    // СТИРАНИЕ ПАМЯТИ (IDX_ERASE)
    // ============================================================================
    else if (event_idx == IDX_ERASE) {
        memcpy(APP_ERASE.BIN + 1, buffer, 63);
        // flash_erase(APP_ERASE.DAT.W_START, APP_ERASE.DAT.W_COUNT);
        flash_erase_area(APP_ERASE.DAT.W_START, APP_ERASE.DAT.W_COUNT);
        PacketSend(APP_ERASE.BIN);
    }
    // ============================================================================
    // ЗАПИСЬ В ПАМЯТЬ (IDX_WRITE)
    // ============================================================================
    else if (event_idx == IDX_WRITE) {
        memcpy(APP_WRITE.BIN + 1, buffer, 63);

        // Проверка: W_COUNT не должен превышать доступные данные (макс 56 байт)
        if (APP_WRITE.DAT.W_COUNT == 0 || APP_WRITE.DAT.W_COUNT > 56) {
            // Можно отправить ошибку, но для совместимости просто ограничим
            APP_WRITE.DAT.W_COUNT = (APP_WRITE.DAT.W_COUNT > 56) ? 56 : APP_WRITE.DAT.W_COUNT;
        }

        // Выравнивание адреса по 4 байта — обязательно
        if ((APP_WRITE.DAT.W_ADRES & 3) != 0) {
            // Опционально: отправить ошибку
        } else {
            // Запись всего блока за один вызов
            flash_write_buffer(APP_WRITE.DAT.W_ADRES, (uint8_t*)APP_WRITE.DAT.W_INFO, APP_WRITE.DAT.W_COUNT);
        }

        PacketSend(APP_WRITE.BIN);
    }
    // ============================================================================
    // ТЕСТ СКОРОСТИ (IDX_APP_SPEED_TEST)
    // ============================================================================
    else if (event_idx == IDX_APP_SPEED_TEST) {
        memcpy(APP_SPEED_TEST.BIN + 1, buffer, 63);
        APP_SPEED_TEST.DAT.R_IDX = IDX_APP_SPEED_TEST;
        APP_SPEED_TEST.DAT.ID = 0;
        PacketSend(APP_SPEED_TEST.BIN);
    }
    // ============================================================================
    // ПЕРЕХОД В BOOTLOADER (IDX_JAMP_TO)
    // ============================================================================
		else if (event_idx == IDX_JAMP_TO_BOOT) {
				memcpy(APP_JAMP_TO_BOOT.BIN + 1, buffer, 63);

				// === Записываем флаг в RTC backup (1 байт) ===
				LPP_BootFlag_Write(LPP_BOOT_MAGIC);

				// Сброс MCU
				HAL_NVIC_SystemReset();
		}
    // ============================================================================
    // УПРАВЛЕНИЕ ЛАЗЕРОМ (IDX_LAZER)
    // ============================================================================
		else if (event_idx == IDX_LAZER) {
        memcpy(LAZER.BIN + 1, buffer, 63);
        
        if (LAZER.DAT.W_SET_L > 0) {
            Laser_Ready(); // Подготовит таймеры и откроет LASER_SAFETY_LOCK
            SetLaserPWM(LAZER.DAT.W_SET_L);
        } else {
            Laser_Off();   // Все выключит и закроет замок
        }
    }
    // ============================================================================
    // УПРАВЛЕНИЕ ПОДСВЕТКОЙ (IDX_LIGHT)
    // ============================================================================
    else if (event_idx == IDX_LIGHT) {
        memcpy(LIGHT.BIN + 1, buffer, 63);
        SetLight1PWM(LIGHT.DAT.W_SET_L);
    }
    // ============================================================================
    // НАСТРОЙКА ОСИ X (IDX_SET_X)
    // ============================================================================
		else if (event_idx == IDX_SET_X) {
        // Копируем данные (убедись, что смещение +1 совпадает с протоколом на ПК)
        memcpy(SET_X.BIN + 1, buffer, 63);

        X_MOTION = SET_X.DAT.W_X_MOTION;

        // 1. Сначала обновляем все настройки полярности
        W_X_POL_DIR = SET_X.DAT.W_X_POL_DIR;
        W_X_POL_PWM = SET_X.DAT.W_X_POL_PWM;
        W_X_POL_EN  = SET_X.DAT.W_X_POL_EN; 

        // Установка уровней для DIR
        if (W_X_POL_DIR == 1) {
            X_DIR_HI = 1; X_DIR_LO = 0;
        } else {
            X_DIR_HI = 0; X_DIR_LO = 1;
        }

        // Установка уровней для STEP/PWM
        if (W_X_POL_PWM == 1) {
            X_STEP_HI = 1; X_STEP_LO = 0;
        } else {
            X_STEP_HI = 0; X_STEP_LO = 1;
        }

        // 2. Инициализируем режим мотора (теперь он знает правильные HI/LO уровни)
        XMotorInit(SET_X.DAT.W_X_MODE);

        // 3. Управление питанием (безопасно, так как режим уже инициализирован)
        XSetEnableStepper(SET_X.DAT.W_X_EN_STEPPER);
        XSetEnableDCBLDC(SET_X.DAT.W_X_EN_DCBLDC);

        // 4. Логика позиций и сброса
        if (SET_X.DAT.W_X_POS_WRITE == 1) {
            X_GO_POS = SET_X.DAT.W_X_MOV_POS;
            SET_X.DAT.W_X_POS_WRITE = 0;
        }
				
				// Если драйвер выключен — целевая позиция следует за энкодером
				// При включении драйвера каретка уже на целевой, движения не будет
				if (SET_X.DAT.W_X_ENABLED == 0) {
						X_GO_POS = X_POS;
						SET_X.DAT.W_X_MOV_POS = X_POS;
				}				

        if (SET_X.DAT.W_X_RESET == 1) {
            X_POS = 0;
            X_GO_POS = 0;
            SET_X.DAT.W_X_MOV_POS = 0;
            SET_X.DAT.W_X_RESET = 0;
        }

        X_KP_POS = SET_X.DAT.X_KP_POS;				
				
				W_X_POWER_MAX = SET_X.DAT.W_X_POWER_MAX;
				W_X_SPEED_SET = SET_X.DAT.W_X_SPEED_SET;
        // 5. Логика Трекинга
        if (SET_X.DAT.W_X_TRECK == 1) {
            X_KP = SET_X.DAT.W_X_KP;
            X_KI = SET_X.DAT.W_X_KI;
            XStartTracking(SET_X.DAT.W_X_L_POS, SET_X.DAT.W_X_R_POS);
        } else {
						XStopTracking();
        }

        X_MIN_POW = SET_X.DAT.W_X_MIN_POW;
        X_ACCL = SET_X.DAT.W_X_ACCL;

        // 6. Подтверждение хосту
        SET_X.DAT.W_X_EN_POS = X_POS;
        SET_X.DAT.W_X_EN_SPEED = W_X_SPEED;
        SET_X.DAT.W_WRITE = 0;
        SET_X.DAT.R_IDX = IDX_SET_X;
        PacketSend(SET_X.BIN);
    }

    // ============================================================================
    // НАСТРОЙКА ОСИ Y (IDX_SET_Y)
    // ============================================================================
    else if (event_idx == IDX_SET_Y) {
        memcpy(SET_Y.BIN + 1, buffer, 63);
        Y_MIN_POW = SET_Y.DAT.W_Y_MIN_POW;
        Y_ACCL = SET_Y.DAT.W_Y_ACCL;
        Y_MOTION = SET_Y.DAT.W_Y_MOTION;

        if (SET_Y.DAT.W_Y_POS_WRITE == 1) {
					if (Y_FINISH_POS == Y_POS) {// только если доехали к позиции
            Y_FINISH_POS = SET_Y.DAT.W_Y_MOV_POS;
            SET_Y.DAT.W_Y_POS_WRITE = 0;					
					}

        } else {
            SET_Y.DAT.W_Y_MOV_POS = Y_FINISH_POS;
        }
        if (SET_Y.DAT.W_Y_RESET == 1) {
            Y_POS = 0;
            Y_FINISH_POS = 0;
            SET_Y.DAT.W_Y_MOV_POS = 0;
            SET_Y.DAT.W_Y_RESET = 0;
        }
        SET_Y.DAT.W_Y_STATUS = Y_STATUS;
        if (SET_Y.DAT.W_Y_POL_DIR == 1) {
            Y_DIR_HI = 1;
            Y_DIR_LO = 0;
        } else {
            Y_DIR_HI = 0;
            Y_DIR_LO = 1;
        }
        if (SET_Y.DAT.W_Y_POL_STEP == 1) {
            Y_STEP_HI = 1;
            Y_STEP_LO = 0;
        } else {
            Y_STEP_HI = 0;
            Y_STEP_LO = 1;
        }

        YSetEnable(SET_Y.DAT.W_Y_ENABLED);

        SET_Y.DAT.W_Y_EN_POS = Y_POS;

        SET_Y.DAT.W_WRITE = 0;
        SET_Y.DAT.R_IDX = IDX_SET_Y;
        PacketSend(SET_Y.BIN);
    }
    // ============================================================================
    // НАСТРОЙКА ОБЩИХ ПАРАМЕТРОВ (IDX_SET_PARAM)
    // ============================================================================
		else if (event_idx == IDX_SET_PARAM) {
				// 1. Копируем данные из буфера (пропускаем Report ID)
				memcpy(SET_PARAM.BIN + 1, buffer, 63);
			
				// 2. Обработка системного светодиода (Heartbeat)
				// СБРАСЫВАЕМ ВОЧДОГ ЗДЕСЬ, потому что пакет пришел!
				LedStatusChangeMS = 0;
				// ========================================================
				if (SET_PARAM.DAT.W_LED_STATUS) {
						F_SET_PIN(&g_pins[PIN_LED_STATUS]);
				} else {
						F_RESET_PIN(&g_pins[PIN_LED_STATUS]);
				}			
			
				// 3. Глобальные настройки (ШИМ и частота) — они не касаются конкретных пинов
			
				SetLaserLightPWMFrequency(SET_PARAM.DAT.W_SET_L_FREQ);
				//SetLaserPWM(SET_PARAM.DAT.W_SET_LAZER); // В отделном пакете
				SetLight1PWM(SET_PARAM.DAT.W_SET_LIGHT1);
				SetLight2PWM(SET_PARAM.DAT.W_SET_LIGHT2);		
						
				// 4. ВСЯ логика с пинами :
				// Она сама проверит, изменился ли порт, сделает DeInit и InitPin
				SetPinConfiguration(
						SET_PARAM.DAT.W_PIN_ID,
						SET_PARAM.DAT.W_PIN_PORT,
						SET_PARAM.DAT.W_PIN_NUM,
						SET_PARAM.DAT.W_PIN_MODE,
						SET_PARAM.DAT.W_PIN_OUT,
						SET_PARAM.DAT.W_PIN_PULL,
						SET_PARAM.DAT.W_PIN_USED
				);
			
				// 5. Ответ хосту
				if (SET_PARAM.DAT.W_ANSWER) {
						PacketSend(SET_PARAM.BIN);
				}
		}
    // ============================================================================
    // ДАННЫЕ ТРЕКИНГА (IDX_TRACK)
    // ============================================================================
    else if (event_idx == IDX_TRACK) {
        memcpy(TRACK.BIN + 1, buffer, 63);
        TRACK.DAT.W_X_EN_POS = X_POS;
        TRACK.DAT.W_X_EN_SPEED = W_X_SPEED;
        TRACK.DAT.W_X_POWER_REAL = W_X_POWER_REAL;
        TRACK.DAT.POLAR = X_POLAR_DYNAMIC;
        PacketSend(TRACK.BIN);
    }
    // ============================================================================
    // ТЕСТ СКОРОСТИ ЭХО (IDX_SPEED_TEST)
    // ============================================================================
    else if (event_idx == IDX_SPEED_TEST) {
        memcpy(SPEED_TEST.BIN + 1, buffer, 63);
        PacketSend(SPEED_TEST.BIN);
    }
}

// ============================================================================
// Функция завершения DMA (вызов из main.c при окончании копирования блока)
// ============================================================================
void FIFO_DATA_EndDma(void) {
    ////////////////////////////////////////////////////////////////    __disable_irq();  // Отключение
    /// прерываний для атомарного обновления FIFO
    // Обновление индексов FIFO после успешной DMA передачи
    if (FIFO_DATA.count < FIFO_DATA.capacity) {                      // Проверка, есть ли место в FIFO
        FIFO_DATA.tail = (FIFO_DATA.tail + 1) % FIFO_DATA.capacity;  // Сдвиг хвоста
        FIFO_DATA.count++;                                           // Увеличение счетчика элементов
    }
    ////////////////////////////////////////////////////////////////    __enable_irq();  // Включение
    /// прерываний
    // Активация печати при получении данных
    if (PRINT_CONFIG.DAT.R_PRINT_STATUS == PRINT_STATUS_PRINT &&  // Проверка, что идет печать
        PRINT_ACTIVE == 0 && START_PRINT == 0) {                  // Проверка флагов активности
        PRINT_ACTIVE = 1;                                         // Устанавливаем флаг активной печати
        PRINT_ACTIVE_COUNT = 0;                                   // Сброс счетчика активной печати
    }
}

// ============================================================================
// Инициализация SDK (вызов из main.c один раз при старте системы)
// ============================================================================
void Lpp_Init(void) {
    // СНАЧАЛА читаем флаг
    uint8_t boot_flag = LPP_BootFlag_Read();
    
    // ПОТОМ чистим cold-power флаг (иначе он может затереть magic!)
    LPP_BootFlag_ColdPowerClear();
    
    // Теперь проверяем
    if (boot_flag == LPP_BOOT_MAGIC) {
        LPP_BootFlag_Write(0x00);
        JumpToApplication(BASE_BOOT_START_ADDR);
    }

		Hardware_Init_System_Pins(); // Инициализация системных пинов	
		
    X_MOTOR_MODE = 255;  // Принудительная инициализация при первом вызове
    // Инициализация параметров печати
    PRINT_CONFIG.DAT.R_PRINT_STATUS = PRINT_STATUS_END;
    // Инициализация подсистем SDK
    FifoData_Init();  // Очистка FIFO данных печати
    FifoPosY_Init();  // Очистка FIFO координат Y
    HAL_Delay(100);
    DWT_Init();  // Инициализация таймера точного времени
    //    PRINT_ACTIVE = 0;     // Сброс флагов состояния
    //    START_PRINT = 0;
    //    SetupPrintJob = 0;

    // При необходимости можно добавить инициализацию лазера, мотора и т.п.
    // SetLaserPWM(0);
    // XMotorInit(X_MOTOR_MODE_START);
}

// ============================================================================
// Основной цикл SDK (вызов из бесконечного while в main.c)
// ============================================================================
void Lpp_MainLoop(void) {
    // ========================================================
    // WATCHDOG ДЛЯ PIN_LED_STATUS
    // Реальное время через DWT->CYCCNT
    // ========================================================
    static uint32_t _last_1ms = 0;
    uint32_t _now = DWT->CYCCNT;
    if (CyclesToMicroseconds(_now - _last_1ms) >= 1000) {
        _last_1ms = _now;
        if (LedStatusChangeMS < 1100) {
            LedStatusChangeMS++;
        }
    }

    // Если пакетов не было больше 1 секунды (1000 мс)
    if (LedStatusChangeMS > 1000) {
        if (SET_PARAM.DAT.W_LED_STATUS_INV) {
            F_SET_PIN(&g_pins[PIN_LED_STATUS]);
        } else {
            F_RESET_PIN(&g_pins[PIN_LED_STATUS]);
        }
    }
    // WATCHDOG ДЛЯ PIN_LED_STATUS END

    // ========================================================
    // ПРОГРАММНЫЙ ШИМ ПОДСВЕТКИ — 500 Гц, 100 шагов
    // 20 мкс × 100 шагов = 2 мс период = 500 Гц
    // ========================================================
    #define LED_STEP_US 20

    static uint32_t _led_last = 0;
    static uint8_t  _led_phase = 0;

    if (CyclesToMicroseconds(_now - _led_last) >= LED_STEP_US) {			
        _led_last = _now;
        if (++_led_phase >= 100) _led_phase = 0;

        if (g_pins[PIN_PWM_LED1].used) {
            if (_led_phase < led1_pwm_val) F_SET_PIN(&g_pins[PIN_PWM_LED1]);
            else                           F_RESET_PIN(&g_pins[PIN_PWM_LED1]);
        }
        if (g_pins[PIN_PWM_LED2].used) {
            if (_led_phase < led2_pwm_val) F_SET_PIN(&g_pins[PIN_PWM_LED2]);
            else                           F_RESET_PIN(&g_pins[PIN_PWM_LED2]);
        }
    }

    // Обработка отправки статуса печати
    if (needSendStatusReport) {
        needSendStatusReport = 0;
        // Гасим LED пока цикл заблокирован retry (до 30 мс)
        if (g_pins[PIN_PWM_LED1].used) F_RESET_PIN(&g_pins[PIN_PWM_LED1]);
        if (g_pins[PIN_PWM_LED2].used) F_RESET_PIN(&g_pins[PIN_PWM_LED2]);
        _led_phase = 0;
        // Попытка отправки с повторениями
        uint8_t retryCount = 3;
        while (retryCount-- > 0) {
            if (PacketSend(PRINT_CONFIG.BIN) == 0) {  // 0 - USBD_OK
                break;
            }
            HAL_Delay(10);  // Задержка между попытками
        }
    }

    // ========================================================
    // ИНИЦИАЛИЗАЦИЯ ЗАДАНИЯ ПЕЧАТИ
    // ========================================================
    if (SetupPrintJob == 1) {
        SetupPrintJob = 0;

        // Инициализация параметров печати
        Y_LINES = PRINT_CONFIG.DAT.W_Y_LINES;        // Число строк в изображении
        INTERPOL_X = PRINT_CONFIG.DAT.W_INTERPOL_X;  // Коэффициент интерполяции
        START_PRINT = 0;                             // Сброс флага начала

        FifoData_Init();  // Сброс FIFO данных печати
        FifoPosY_Init();  // Сброс FIFO позиций Y

        // Установка статуса "занят"
        PRINT_CONFIG.DAT.R_PRINT_STATUS = PRINT_STATUS_BUSY;
        Y_IMAGE_POSITION = 0;  // Сброс позиции строки

        // Инициализация переменных печати
        CURRENT_PRINT_DIRECTION = 0;  // Начальное направление слева направо

        // Определение границ зоны печати
        PRINT_LEFT_BORDER = PRINT_CONFIG.DAT.W_LASER_INITIAL_POSITION_X;
        PRINT_RIGHT_BORDER = PRINT_LEFT_BORDER + PRINT_CONFIG.DAT.W_BOARD_LENGTH_X - 1;

        // Позиционирование по оси Y
        Y_FINISH_POS = PRINT_CONFIG.DAT.W_LASER_INITIAL_POSITION_Y;

        // Ожидание достижения позиции Y
        // Гасим LED на время блокировки цикла (до 10 секунд)
        if (g_pins[PIN_PWM_LED1].used) F_RESET_PIN(&g_pins[PIN_PWM_LED1]);
        if (g_pins[PIN_PWM_LED2].used) F_RESET_PIN(&g_pins[PIN_PWM_LED2]);
        _led_phase = 0;
        uint8_t y_position_ready = 0;
        for (int i = 0; i < 100; i++) {
            HAL_Delay(100);
            if (Y_FINISH_POS == Y_POS) {
                y_position_ready = 1;
                break;
            }
        }

        // Проверка успешности позиционирования Y
        if (!y_position_ready) {
            PRINT_CONFIG.DAT.R_PRINT_STATUS = PRINT_STATUS_ERROR_Y;
            PacketSend(PRINT_CONFIG.BIN);
        } else {
            // ========================================================
            // УСПЕШНОЕ ПОЗИЦИОНИРОВАНИЕ Y - ЗАПУСК ПЕЧАТИ
            // ========================================================

            // Сброс флагов печати
            START_PRINT = 0;
            PRINT_ACTIVE = 0;
            PRINT_ACTIVE_COUNT = 0;
            CURRENT_PRINT_DIRECTION = 0;
            FifoData_ReadBitReset();  // Сброс состояния чтения битов

            if (X_MOTOR_MODE == X_MOTOR_MODE_STEP) {
                // ========================================================
                // ИНИЦИАЛИЗАЦИЯ ДЛЯ СТЕППЕРА
                // ========================================================
                // Параметры разгона/торможения для степпера
                X_MIN_POW = PRINT_CONFIG.DAT.W_X_SPEED_SET;  // Минимальный период (максимальная скорость)
                X_ACCL = PRINT_CONFIG.DAT.W_X_AXIS_ACCELERATION;  // Длина зоны разгона в шагах

                // Границы с учетом разгона/торможения
                SET_X.DAT.W_X_L_POS = PRINT_CONFIG.DAT.W_LASER_INITIAL_POSITION_X - X_ACCL;
                SET_X.DAT.W_X_R_POS =
                    PRINT_CONFIG.DAT.W_LASER_INITIAL_POSITION_X + PRINT_CONFIG.DAT.W_BOARD_LENGTH_X + X_ACCL;

                XStartTracking(SET_X.DAT.W_X_L_POS, SET_X.DAT.W_X_R_POS);

            } else {
                // ========================================================
                // ИНИЦИАЛИЗАЦИЯ ДЛЯ DC МОТОРА
                // ========================================================
                // ========================================================
                // НАСТРОЙКА ПАРАМЕТРОВ УПРАВЛЕНИЯ ОСЬЮ X
                // ========================================================
                W_X_POWER_MAX = PRINT_CONFIG.DAT.W_X_POWER_MAX;  // Максимальная мощность
                W_X_SPEED_SET = PRINT_CONFIG.DAT.W_X_SPEED_SET;  // Скорость движения
                X_KP = PRINT_CONFIG.DAT.W_X_KP;                  // Коэффициент P
                X_KI = PRINT_CONFIG.DAT.W_X_KI;                  // Коэффициент I

                // Установка крайних позиций с учетом зоны разгона/торможения
                SET_X.DAT.W_X_L_POS =
                    PRINT_CONFIG.DAT.W_LASER_INITIAL_POSITION_X - PRINT_CONFIG.DAT.W_X_AXIS_ACCELERATION;
                SET_X.DAT.W_X_R_POS = PRINT_CONFIG.DAT.W_LASER_INITIAL_POSITION_X +
                                      PRINT_CONFIG.DAT.W_BOARD_LENGTH_X +
                                      PRINT_CONFIG.DAT.W_X_AXIS_ACCELERATION;

                // ========================================================
                // ЗАПУСК ТРЕКИНГА (НОВАЯ ЛОГИКА)
                // ========================================================
                // Автоматический запуск трекинга с определением ближайшей границы
                XStartTracking(SET_X.DAT.W_X_L_POS, SET_X.DAT.W_X_R_POS);
            }

            // ========================================================
            // ЗАВЕРШЕНИЕ ИНИЦИАЛИЗАЦИИ (общее для обоих режимов)
            // ========================================================
            PRINT_CONFIG.DAT.R_PRINT_STATUS = PRINT_STATUS_PRINT;
            PacketSend(PRINT_CONFIG.BIN);
        }
    }
}

// ============================================================================
// Движение по оси Y
// direction: 1 = вверх, -1 = вниз
// ============================================================================
void YMove(int direction) {
    if (Y_PIN == 1) {
        Y_PIN = 0;
        YSetStep(Y_STEP_HI);  // Фронт STEP
        Y_POS += direction;   // Обновляем позицию
    } else {
        Y_PIN = 1;
        // Установка направления перед импульсом
        if (direction == 1) {
            YSetDir(Y_DIR_HI);  // Вверх
        } else {
            YSetDir(Y_DIR_LO);  // Вниз
        }
        YSetStep(Y_STEP_LO);  // Подготовка к следующему шагу
    }
}

// ============================================================================
// Расчет мощности (скорости) для оси Y
// ============================================================================
int YCalculatePower(void) {
    int index = 0;
    // Расчет середины пути между стартовой и конечной позицией
    Y_HALF_POS = Y_START_POS + ((Y_FINISH_POS - Y_START_POS) / 2);
    // --- Если целевая позиция ниже текущей — двигаемся вниз ---
    if (Y_FINISH_POS < Y_POS) {
        YMove(-1);  // Делаем один шаг вниз
        // Выбираем участок разгона или торможения по положению относительно середины
        index = (Y_POS > Y_HALF_POS) ? (Y_START_POS - Y_POS) : (Y_POS - Y_FINISH_POS);
    }
    // --- Если целевая позиция выше текущей — двигаемся вверх ---
    else if (Y_FINISH_POS > Y_POS) {
        YMove(1);  // Делаем один шаг вверх
        index = (Y_POS < Y_HALF_POS) ? (Y_POS - Y_START_POS) : (Y_FINISH_POS - Y_POS);
    }
    // --- Если достигнута целевая позиция ---
    else {
        index = 0;  // Скорость минимальная (остановка)
    }
    // Ограничение диапазона индекса, чтобы не выйти за границы массива TUNING_Y
    if (index < 0) index = 0;
    if (index >= Y_ACCL) index = Y_ACCL - 1;
    // Расчет мощности (скорости) на основе таблицы ускорения
    int power = Y_MIN_POW + TUNING_Y[index];
    // Возвращаем положительное значение мощности
    return (power > 0) ? power : 1;
}

// ============================================================================
// Обработчик таймера оси Y
// (вызывать из прерывания таймера в main.c)
// ============================================================================
void YTimerCallback(void) {
    // Определяем конечную позицию для текущего режима движения
    if (Y_MOTION == 1) Y_FINISH_POS = Y_POS + Y_ACCL;  // движение вверх
    if (Y_MOTION == 2) Y_FINISH_POS = Y_POS - Y_ACCL;  // движение вниз
    // Обновляем статус: 0 = BUSY, 1 = READY
    Y_STATUS = (Y_FINISH_POS == Y_POS) ? 1 : 0;
    // Если движение продолжается — вычисляем скорость/мощность, иначе ставим минимальную
    Y_REAL_SPED = (Y_FINISH_POS != Y_POS) ? YCalculatePower() : Y_MIN_POW; 		
    // Если мы только начали или закончили движение — обновляем стартовую точку
    Y_START_POS = ((Y_POS == Y_START_POS) || (Y_POS == Y_FINISH_POS)) ? Y_POS : Y_START_POS;
    // Настраиваем таймер на новый период (зависит от скорости)
    // Это задаёт частоту вызовов YTimerCallback, а значит — частоту шагов
    YTimerSet(Y_REAL_SPED);
}

// ============================================================================
// Движение по оси X (в режиме X_MOTOR_MODE_STEP)
// direction: 1 = вправо, -1 = влево
// ============================================================================
void XMove(int direction) {
    if (X_PIN == 1) {
        X_PIN = 0;
        XSetStep(X_STEP_HI);  // Фронт STEP
        X_POS += direction;

        // Обработка печати после каждого шага
        XStepperStepCallback(direction);

    } else {
        X_PIN = 1;
        if (direction == 1) {
            XSetDir(X_DIR_HI);  // Вправо
        } else {
            XSetDir(X_DIR_LO);  // Влево
        }
        XSetStep(X_STEP_LO);  // Подготовка к следующему шагу
    }
}

// ============================================================================
// Расчет периода (скорости) для оси X в шаговом режиме
// ============================================================================
int XCalculatePower(void) {
    int index = 0;
    // Расчет середины пути
    X_HALF_POS = X_START_POS + ((X_GO_POS - X_START_POS) / 2);

    if (X_GO_POS < X_POS) {
        // Движение влево
        XMove(-1);
        index = (X_POS > X_HALF_POS) ? (X_START_POS - X_POS) : (X_POS - X_GO_POS);
    } else if (X_GO_POS > X_POS) {
        // Движение вправо
        XMove(1);
        index = (X_POS < X_HALF_POS) ? (X_POS - X_START_POS) : (X_GO_POS - X_POS);
    } else {
        index = 0;  // Остановка
    }
    if (index < 0) index = 0;
    if (index >= X_ACCL) index = X_ACCL - 1;
    // Используем  массив TUNING_X
    int period = X_MIN_POW + TUNING_X[index];
    return (period > 0) ? period : 1;
}

// ============================================================================
// Ограничение значения с защитой от переполнения
// Используется при переходе int32_t → int16_t (мощность, аккумуляторы)
// ============================================================================
static inline int16_t clamp16(int32_t v, int16_t min, int16_t max) {
    if (v > max) return max;
    if (v < min) return min;
    return (int16_t)v;
}

// ============================================================================
// ОБРАБОТЧИК ЛОГИКИ ОСИ X - секция трекинга
// По сути сам ПИД X
// ============================================================================
void XTimerCallback(void) {
		DWT_1kHz_Handler();	
	
    // ========================================================
    // РЕЖИМ ШАГОВОГО МОТОРА
    // ========================================================
    if (X_MOTOR_MODE == X_MOTOR_MODE_STEP) {
        // --- Определяем стартовую позицию при начале движения ---
        if (X_POS == X_START_POS || X_POS == X_GO_POS) X_START_POS = X_POS;

        // ========================================================
        // НЕПРЕРЫВНОЕ ДВИЖЕНИЕ
        // ========================================================
        if (X_MOTION == X_MOTION_RIGHT) {
            // Непрерывное движение вправо
            X_GO_POS = X_POS + X_ACCL;
        } else if (X_MOTION == X_MOTION_LEFT) {
            // Непрерывное движение влево
            X_GO_POS = X_POS - X_ACCL;
        }

        // ========================================================
        // ОСТАНОВ ТРЕКИНГА ПРИ ДОСТИЖЕНИИ ЦЕЛИ
        // ========================================================
        if (X_STOPPING) {
            if (X_POS == X_GO_POS) {
                X_TRACKING_ACTIVE = 0;
                // --- Выполнить возврат только один раз ---
                if (X_RETURN_DONE == 0) {
                    X_GO_POS = SET_X.DAT.W_X_MOV_POS;
                    X_RETURN_DONE = 1;  // ← больше не выполняем
                }
            }
        }

        // ========================================================
        // РЕЖИМ ЦИКЛИЧЕСКОГО БЕГА (ТРЕКИНГ)
        // ========================================================
        if (X_TRACKING_ACTIVE) {
            if (X_POS <= SET_X.DAT.W_X_L_POS) X_GO_POS = SET_X.DAT.W_X_R_POS;
            if (X_POS >= SET_X.DAT.W_X_R_POS) X_GO_POS = SET_X.DAT.W_X_L_POS;
        }

        // ========================================================
        // РАСЧЕТ СКОРОСТИ + УСТАНОВКА ТАЙМЕРА
        // ========================================================
        X_REAL_SPED = (X_GO_POS != X_POS) ? XCalculatePower() : X_MIN_POW;
        XTimerSet(X_REAL_SPED);
    }

    // ========================================================
    // РЕЖИМ DC МОТОРА
    // ========================================================
    else {
        // ========================================================
        // Режим циклического бега (трекинг)
        // ========================================================
        if (X_TRACKING_ACTIVE == 1) {
            // --- 1. Фильтрация скорости энкодера ---
            if (W_X_SPEED == 0 || W_X_SPEED == 0xFFFF) {
                W_X_SPEED_FILTERED = 0;
            } else if (W_X_SPEED >= SPEED_MIN_TICKS && W_X_SPEED <= SPEED_MAX_TICKS) {
                int32_t speed_val = 65535 / (int32_t)W_X_SPEED;
                W_X_SPEED_FILTERED = (W_X_EN_DIRECT == 1)    ? speed_val
                                     : (W_X_EN_DIRECT == -1) ? -speed_val
                                                             : 0;
            }

            // --- 2. ЖЕСТКАЯ проверка граничных позиций ---
            if (X_POS >= SET_X.DAT.W_X_R_POS) {
                if (X_POLAR_DYNAMIC != 1) {
                    X_POLAR_DYNAMIC = 1;           // Разворот влево
                    W_X_SPEED_ERROR_INTEGRAL = 0;  // Сброс интегратора
                }
            } else if (X_POS <= SET_X.DAT.W_X_L_POS) {
                if (X_POLAR_DYNAMIC != 0) {
                    X_POLAR_DYNAMIC = 0;  // Разворот вправо
                    W_X_SPEED_ERROR_INTEGRAL = 0;
                }
            }

            // --- 3. Целевая скорость со знаком ---
            W_X_SPEED_SET_POLAR = (X_POLAR_DYNAMIC == 0) ? W_X_SPEED_SET : -W_X_SPEED_SET;

            // --- 4. PID-регулятор ---
            W_X_SPEED_ERROR = W_X_SPEED_SET_POLAR - W_X_SPEED_FILTERED;
            W_X_P_component = (int32_t)W_X_SPEED_ERROR * (int32_t)X_KP;

            W_X_SPEED_ERROR_INTEGRAL += W_X_SPEED_ERROR;
            if (W_X_SPEED_ERROR_INTEGRAL > X_INTEGRAL_MAX)
                W_X_SPEED_ERROR_INTEGRAL = X_INTEGRAL_MAX;
            else if (W_X_SPEED_ERROR_INTEGRAL < X_INTEGRAL_MIN)
                W_X_SPEED_ERROR_INTEGRAL = X_INTEGRAL_MIN;

            W_X_I_component = (W_X_SPEED_ERROR_INTEGRAL * (int32_t)X_KI) / 100;
            W_X_PI_sum = W_X_P_component + W_X_I_component;

            W_X_POWER_REAL = clamp16(W_X_PI_sum, -W_X_POWER_MAX, W_X_POWER_MAX);

            XMotorSet(W_X_POWER_REAL);

        } else {
            // ========================================================
            // Режим позиционирования + скорость (JOG)
            // ========================================================
            if (SET_X.DAT.W_X_ENABLED == 1) {
                // =================================================
                // JOG MODE — скоростное управление
                // =================================================
                if (X_MOTION == X_MOTION_RIGHT || X_MOTION == X_MOTION_LEFT) {
// ------------------------------------------------
// Формирование виртуальной позиции
// ------------------------------------------------
#define X_JOG_OFFSET 2
#define X_JOG_POWER_STEP 20

                    if (X_MOTION == X_MOTION_RIGHT)
                        X_GO_POS = X_POS + X_JOG_OFFSET;
                    else
                        X_GO_POS = X_POS - X_JOG_OFFSET;

                    // ------------------------------------------------
                    // Фильтрация скорости (с защитой)
                    // ------------------------------------------------
                    if (W_X_SPEED == 0 || W_X_SPEED == 0xFFFF) {
                        W_X_SPEED_FILTERED = 0;
                    } else {
                        int32_t tmp_speed = 65535 / W_X_SPEED;
                        if (tmp_speed > INT16_MAX) tmp_speed = INT16_MAX;
                        W_X_SPEED_FILTERED = (int16_t)tmp_speed;
                    }

                    // ------------------------------------------------
                    // Определение направления
                    // ------------------------------------------------
                    int8_t dir = ((X_GO_POS - X_POS) > 0) ? 1 : -1;

                    // ------------------------------------------------
                    // Регулирование мощности (БЕЗ переполнения)
                    // ------------------------------------------------
                    int16_t step =
                        (W_X_SPEED_FILTERED > W_X_SPEED_SET) ? -X_JOG_POWER_STEP : X_JOG_POWER_STEP;

                    int32_t tmp_power = (int32_t)W_X_POWER_REAL + (step * dir);

                    W_X_POWER_REAL = clamp16(tmp_power, -W_X_POWER_MAX, W_X_POWER_MAX);
                }

                // =================================================
                // POSITION MODE — позиционное управление
                // =================================================
                else {
                    int32_t position_error = X_GO_POS - X_POS;

                    if (position_error != 0) {
                        // ------------------------------------------------
                        // Контроль движения
                        // ------------------------------------------------
                        int32_t position_delta = X_POS - X_LAST_POSITION;
                        X_LAST_POSITION = X_POS;

                        // ------------------------------------------------
                        // Пропорциональная составляющая (P)
                        // ------------------------------------------------
                        int32_t base_power = position_error * X_KP_POS;

                        // ------------------------------------------------
                        // Если позиция не меняется — наращиваем усилие
                        // ------------------------------------------------
                        if (position_delta == 0) {
                            int32_t power_step = SET_X.DAT.W_X_POWER_STEP;

                            int32_t acc = X_POWER_ACCUM + ((position_error > 0) ? power_step : -power_step);

                            X_POWER_ACCUM = clamp16(acc, -W_X_POWER_MAX, W_X_POWER_MAX);
                        } else {
                            X_STUCK_COUNTER = 0;
                            X_POWER_ACCUM = 0;
                        }

                        // ------------------------------------------------
                        // Итоговая мощность (с защитой)
                        // ------------------------------------------------
                        int32_t total_power = base_power + X_POWER_ACCUM;

                        W_X_POWER_REAL = clamp16(total_power, -W_X_POWER_MAX, W_X_POWER_MAX);
                    } else {
                        // ------------------------------------------------
                        // Цель достигнута — сброс регулятора
                        // ------------------------------------------------
                        W_X_POWER_REAL = 0;
                        X_POWER_ACCUM = 0;
                        X_STUCK_COUNTER = 0;
                        X_LAST_POSITION = X_POS;
                    }
                }

                // =================================================
                // Вывод на драйвер мотора
                // =================================================
                XMotorSet(W_X_POWER_REAL);

            } else {
                // Ось отключена
                XMotorSet(0);
            }
        }
    }
}

// ============================================================================
// Функции управления физическими пинами (Hardware Layer)
// Эти функции обеспечивают абстракцию логики принтера от конкретных ножек МК.
// ============================================================================
/**
 * @brief Инициализация системных пинов
 */
void Hardware_Init_System_Pins(void) {
    // Только USB_EN (PA8)
    PIN_CFG_T* cfg = &g_pins[SYS_PIN_USB_EN];

    cfg->used   = 1;
    cfg->pin    = (1U << 8); 
    cfg->mode   = PIN_MODE_OUTPUT;
    cfg->outcfg = PIN_OUT_PP;
    cfg->pull   = PIN_NOPULL;
    cfg->bsrr   = (volatile uint32_t*)&GPIOA->BSRR;
    cfg->idr    = (volatile uint32_t*)&GPIOA->IDR;

    InitPinEx(cfg, false); 
}

/**
 * @brief Управление шагом оси X (STEP).
 * Физика: Устанавливает уровень на PB13 (драйвер платы) и PB2 (выход DB25).
 */
void XSetStep(uint8_t state) 
{
    if (state) {    
        F_SET_PIN(&g_pins[PIN_X_STEP_DB25]); 			
    } else {
        F_RESET_PIN(&g_pins[PIN_X_STEP_DB25]);			
    }
}

/**
 * @brief Управление направлением оси X (DIR).
 */
void XSetDir(uint8_t state) 
{
    if (state) {     
        F_SET_PIN(&g_pins[PIN_X_DIR_DB25]);       
    } else {
        F_RESET_PIN(&g_pins[PIN_X_DIR_DB25]); 
    }
}

/**
 * @brief Управление включением шагового двигателя X (Stepper Enable).
 * Активирует линии драйвера шаговика на плате и через DB25.
 */
void XSetEnableStepper(uint8_t state) 
{
    if (state) {
        F_SET_PIN(&g_pins[PIN_X_EN_DB25]);   
    } else {  
        F_RESET_PIN(&g_pins[PIN_X_EN_DB25]); 
    }
}

/**
 * @brief Управление питанием DC/BLDC мотора X (Power Enable).
 * Активирует силовые выходы для режимов постоянного тока или бесщеточных двигателей.
 */
void XSetEnableDCBLDC(uint8_t state) 
{
    if (state) {
        // Здесь используем твои другие пины, предназначенные для DC/BLDC
				F_SET_PIN(&g_pins[PIN_X_MO_EN]); 
    } else {
				F_RESET_PIN(&g_pins[PIN_X_MO_EN]);
    }
}

/**
 * @brief Управление шагом оси Y (STEP).
 */
void YSetStep(uint8_t state) 
{
    if (state) F_SET_PIN(&g_pins[PIN_Y_STEP]); // PB0
    else       F_RESET_PIN(&g_pins[PIN_Y_STEP]);
}

/**
 * @brief Управление направлением оси Y (DIR).
 */
void YSetDir(uint8_t state) 
{
    if (state) F_SET_PIN(&g_pins[PIN_Y_DIR]); // PB1
    else       F_RESET_PIN(&g_pins[PIN_Y_DIR]);
}

/**
 * @brief Глобальное управление ENABLE для всех осей (Y, Z).
 * Синхронно управляет пинами через массив g_pins.
 */
void YSetEnable(uint8_t state) 
{
    if (state) {
        // --- ВКЛЮЧАЕМ МОТОРЫ (Active Low) ---
        F_RESET_PIN(&g_pins[PIN_Y_EN]);
        F_RESET_PIN(&g_pins[PIN_Z_EN]);
    } 
    else {
        // --- ВЫКЛЮЧАЕМ МОТОРЫ ---
        F_SET_PIN(&g_pins[PIN_Y_EN]);
        F_SET_PIN(&g_pins[PIN_Z_EN]);
    }       
}
