DimaFantasy/LPP/BOOT_STM32G431CBTx/Core/Src/main.c

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
/* Includes ------------------------------------------------------------------*/
#include "main.h"
#include "usb_device.h"

/* USER CODE BEGIN Includes */
#include "lpp_sdk.h"
#include "counter.h"

/* USER CODE END Includes */

/* USER CODE BEGIN PM */

// ============================================================================
// Сигнатура и версия прошивки (APP)
// ============================================================================
const uint32_t BOOT_KEY0   __attribute__((section(BOOT_KEY0_SECTION)))   = BOOT_SIG_KEY0;
const uint32_t BOOT_KEY1   __attribute__((section(BOOT_KEY1_SECTION)))   = BOOT_SIG_KEY1;
const uint32_t BOOT_KEY2   __attribute__((section(BOOT_KEY2_SECTION)))   = BOOT_SIG_KEY2;
const uint32_t BOOT_KEY3   __attribute__((section(BOOT_KEY3_SECTION)))   = BOOT_SIG_KEY3;

const uint32_t BOOT_VER_F  __attribute__((section(BOOT_VER_F_SECTION)))  = BOOT_VERSION;

/* USER CODE END PM */


void SystemClock_Config(void);
static void MX_GPIO_Init(void);
/**
  * @brief  The application entry point.
  * @retval int
  */
int main(void)
{

  /* MCU Configuration--------------------------------------------------------*/

  /* Reset of all peripherals, Initializes the Flash interface and the Systick. */
  HAL_Init();

  /* Configure the system clock */
  SystemClock_Config();

  /* Initialize all configured peripherals */
  MX_GPIO_Init();
  MX_USB_Device_Init();
  /* USER CODE BEGIN 2 */
    // Инициализация USB
    USB->BCDR &= ~USB_BCDR_DPPU; // DPPU = 0 → подтяжка DP отключена
    HAL_GPIO_WritePin(GPIOA, GPIO_PIN_8, GPIO_PIN_RESET);  // Выключение USB
    HAL_Delay(2000);
    HAL_GPIO_WritePin(GPIOA, GPIO_PIN_8, GPIO_PIN_SET);  // Включение USB
    USB->BCDR |= USB_BCDR_DPPU; // DPPU = 1 → подтяжка DP включена 
  /* USER CODE END 2 */

  /* Infinite loop */
  /* USER CODE BEGIN WHILE */
  while (1)
  {
    /* USER CODE END WHILE */
    /* USER CODE BEGIN 3 */
  }
  /* USER CODE END 3 */
}

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
/* USER CODE BEGIN 4 */

// ============================================================================
// Отправка 64-байтного пакета хосту (используется SDK)
// ============================================================================
extern uint8_t USBD_CUSTOM_HID_SendReport(USBD_HandleTypeDef* pdev, uint8_t* report, uint16_t len);
extern USBD_HandleTypeDef hUsbDeviceFS;

uint8_t PacketSend(uint8_t* buffer)
{
    // Отправка HID отчёта (64 байта)
    return USBD_CUSTOM_HID_SendReport(&hUsbDeviceFS, buffer, 64);
}

/* USER CODE END 4 */
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
