DimaFantasy/LPP/(commit log)

2025-11-02 new file: .gitignore new file: BOOT_STM32F103Cx/.mxproject new file: BOOT_STM32F103Cx/Boot.ioc new file: BOOT_STM32F103Cx/Core/Inc/main.h new file: BOOT_STM32F103Cx/Core/Inc/stm32f1xx_hal_conf.h new 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
2025-11-02 deleted: "LPP_STM32F103Cx/LPP_STM32F103Cx \342\200\224 \320\272\320\276\320\277\320\270\321\217.ioc" modified: LPP_STM32F103Cx/MDK-ARM/LPP_STM32F103Cx.uvguix.user modified: README.md
2025-11-04 modified: LPP_SDK/lpp_sdk.c modified: LPP_STM32F103Cx/MDK-ARM/JLinkLog.txt modified: LPP_STM32F103Cx/MDK-ARM/LPP_STM32F103Cx.uvguix.user modified: LPP_STM32F103Cx/MDK-ARM/LPP_STM32F103Cx.uvoptx modif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
2025-11-05 Changes to be committed: modified: LPP_SDK/lpp_sdk.c modified: LPP_STM32F103Cx/Core/Src/main.c modified: LPP_STM32F103Cx/MDK-ARM/JLinkLog.txt modified: LPP_STM32F103Cx/MDK-ARM/LPP_STM32F103Cx.uvguix.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
2025-11-05 modified: LPP_STM32F103Cx/Core/Src/main.c modified: LPP_STM32F103Cx/MDK-ARM/LPP_STM32F103Cx.uvguix.user modified: LPP_STM32F103Cx/MDK-ARM/LPP_STM32F103Cx.uvoptx modified: LPP_STM32F103Cx/MDK-ARM/LPP_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
2025-11-15 modified: LPP_STM32F103Cx/MDK-ARM/LPP_STM32F103Cx.uvguix.user renamed: LPP_STM32G431Cx/Schematic Prints.pdf -> LPP_STM32G431Cx/Schematic Prints_64.pdf new file: PCB/LPP MainBoard Gen_1_Ver_1.brd new 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
    [LPP MainBoard Gen_1_Ver_1.brd, LPP MainBoard Gen_1_Ver_1.dch, LPP MainBoard Gen_1_Ver_1.sch, LPP_Carriage_Module_Gen_1 Ver_1.dip, LPP_Carriage_Module_Gen_1_Ver_1.dch, LPP_Carriage_Module_Gen_2_Ver_1.dch, LPP_Carriage_Module_Gen_2_Ver_1.dip, LPP_MainBoard_Gen_1_Ver_1.dip]
2025-11-15 modified: PCB/README.md
2025-11-15 modified: PCB/LPP_MainBoard_Gen_1_Ver_1.dip new file: PCB/LPP_MainBoard_Gen_1_Ver_1/Through.drl modified: PCB/README.md
    [LPP_MainBoard_Gen_1_Ver_1.dip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]
2025-11-16 modified: PCB/LPP MainBoard Gen_1_Ver_1.brd modified: PCB/LPP MainBoard Gen_1_Ver_1.dch modified: PCB/LPP MainBoard Gen_1_Ver_1.sch modified: PCB/LPP_MainBoard_Gen_1_Ver_1.dip deleted: PCB/LPP_MainBo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
    [LPP MainBoard Gen_1_Ver_1.brd, LPP MainBoard Gen_1_Ver_1.dch, LPP MainBoard Gen_1_Ver_1.sch, LPP_MainBoard_Gen_1_Ver_1.dip, komtur.dxf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]
2025-11-17 modified: PCB/LPP MainBoard Gen_1_Ver_1.brd modified: PCB/LPP MainBoard Gen_1_Ver_1.dch modified: PCB/LPP MainBoard Gen_1_Ver_1.sch modified: PCB/LPP_MainBoard_Gen_1_Ver_1.dip new file: PCB/LPP_MainB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
    [LPP MainBoard Gen_1_Ver_1.brd, LPP MainBoard Gen_1_Ver_1.dch, LPP MainBoard Gen_1_Ver_1.sch, LPP_MainBoard_Gen_1_Ver_1.dip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]
2025-11-18 new file: PCB/LPP MainBoard Gen_1_Ver_1.kicad_dru renamed: PCB/LPP MainBoard Gen_1_Ver_1.dch -> PCB/LPP_MainBoard_Gen_1_Ver_1.dch modified: PCB/LPP_MainBoard_Gen_1_Ver_1.dip modified: PCB/LPP_MainBoa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
    [LPP MainBoard Gen_1_Ver_1.dch, LPP_MainBoard_Gen_1_Ver_1.dch, LPP_MainBoard_Gen_1_Ver_1.dip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]
2025-11-18 modified: PCB/LPP MainBoard Gen_1_Ver_1.brd modified: PCB/LPP MainBoard Gen_1_Ver_1.sch
    [LPP MainBoard Gen_1_Ver_1.brd, LPP MainBoard Gen_1_Ver_1.sch]
2025-11-18 modified: PCB/LPP MainBoard Gen_1_Ver_1.sch modified: PCB/LPP_MainBoard_Gen_1_Ver_1.dch modified: PCB/README.md
    [LPP MainBoard Gen_1_Ver_1.sch, LPP_MainBoard_Gen_1_Ver_1.dch]
2025-11-20 modified: PCB/LPP MainBoard Gen_1_Ver_1.brd modified: PCB/LPP MainBoard Gen_1_Ver_1.sch modified: PCB/LPP_MainBoard_Gen_1_Ver_1.dch modified: PCB/LPP_MainBoard_Gen_1_Ver_1.dip
    [LPP MainBoard Gen_1_Ver_1.brd, LPP MainBoard Gen_1_Ver_1.sch, LPP_MainBoard_Gen_1_Ver_1.dch, LPP_MainBoard_Gen_1_Ver_1.dip]
2025-11-21 modified: PCB/LPP_MainBoard_Gen_1_Ver_1.dch modified: PCB/LPP_MainBoard_Gen_1_Ver_1.dip new file: "PCB/LPP_MainBoard_Gen_1_Ver_1/1 - \320\222\320\265\321\200\321\205\320\275\320\270\320\271.gbr" new 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
    [LPP_MainBoard_Gen_1_Ver_1.dch, LPP_MainBoard_Gen_1_Ver_1.dip, komtur.dxf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]
2025-12-03 modified: LPP_STM32F103Cx/Core/Src/main.c modified: LPP_STM32F103Cx/LPP_STM32F103Cx.ioc modified: LPP_STM32F103Cx/MDK-ARM/JLinkLog.txt modified: LPP_STM32F103Cx/MDK-ARM/LPP_STM32F103Cx.uvguix.user mo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
    [LPP MainBoard Gen_1_Ver_1.brd, LPP MainBoard Gen_1_Ver_1.sch, LPP_MainBoard_Gen_1_Ver_1 — копия.dch, LPP_MainBoard_Gen_1_Ver_1 — копия.dip, LPP_MainBoard_Gen_1_Ver_1.dch, LPP_MainBoard_Gen_1_Ver_1.dip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]
2025-12-03 modified: PCB/LPP MainBoard Gen_1_Ver_1.brd deleted: "PCB/LPP_MainBoard_Gen_1_Ver_1 \342\200\224 \320\272\320\276\320\277\320\270\321\217.dch" deleted: "PCB/LPP_MainBoard_Gen_1_Ver_1 \342\200\224 \32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
    [LPP MainBoard Gen_1_Ver_1.brd, LPP_MainBoard_Gen_1_Ver_1 — копия.dch, LPP_MainBoard_Gen_1_Ver_1 — копия.dip, LPP_MainBoard_Gen_1_Ver_1.dip]
2025-12-03 modified: PCB/LPP MainBoard Gen_1_Ver_1.brd modified: PCB/LPP_MainBoard_Gen_1_Ver_1.dip
    [LPP MainBoard Gen_1_Ver_1.brd, LPP_MainBoard_Gen_1_Ver_1.dip]
2025-12-04 modified: LPP_STM32F103Cx/MDK-ARM/JLinkLog.txt modified: LPP_STM32F103Cx/MDK-ARM/LPP_STM32F103Cx.uvguix.user modified: PCB/LPP MainBoard Gen_1_Ver_1.brd modified: PCB/LPP_MainBoard_Gen_1_Ver_1.dip
    [LPP MainBoard Gen_1_Ver_1.brd, LPP_MainBoard_Gen_1_Ver_1.dip]
2025-12-04 modified: LPP_SDK/lpp_sdk.c modified: LPP_SDK/lpp_sdk.h modified: LPP_STM32F103Cx/Core/Src/main.c modified: LPP_STM32F103Cx/MDK-ARM/JLinkLog.txt modified: LPP_STM32F103Cx/MDK-ARM/LPP_STM32F103Cx.uvgu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
    [LPP MainBoard Gen_1_Ver_1.brd]
2025-12-04 new file: PCB/LPP_MainBoard_Gen_1_Ver_1.brd renamed: PCB/LPP MainBoard Gen_1_Ver_1.sch -> PCB/LPP_MainBoard_Gen_1_Ver_1.sch
    [LPP_MainBoard_Gen_1_Ver_1.brd, LPP_MainBoard_Gen_1_Ver_1.sch]
2025-12-07 modified: LPP_SDK/lpp_sdk.c modified: LPP_SDK/lpp_sdk.h modified: LPP_STM32F103Cx/Core/Src/main.c modified: LPP_STM32F103Cx/LPP_STM32F103Cx.ioc modified: LPP_STM32F103Cx/MDK-ARM/JLinkLog.txt modified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
2025-12-09 new file: LPP_SDK/configs/lpp_config_g431_alt.h modified: LPP_STM32F103Cx/MDK-ARM/LPP_STM32F103Cx/LPP_STM32F103Cx.axf modified: LPP_STM32F103Cx/MDK-ARM/LPP_STM32F103Cx/LPP_STM32F103Cx.build_log.htm m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
2025-12-11 modified: LPP_SDK/lpp_sdk.c modified: LPP_STM32F103Cx/MDK-ARM/JLinkLog.txt modified: LPP_STM32F103Cx/MDK-ARM/LPP_STM32F103Cx.uvguix.user modified: LPP_STM32F103Cx/MDK-ARM/LPP_STM32F103Cx/LPP_STM32F10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
    [LPP_MainBoard_Gen_1_Ver_1.dch]
2025-12-17 deleted: PCB/LPP_MainBoard_Gen_1_Ver_1.brd deleted: PCB/LPP_MainBoard_Gen_1_Ver_1.sch renamed: PCB/LPP_MainBoard_Gen_1_Ver_1.dch -> PCB/LPP_MainBoard_Gen_1_Ver_2.dch renamed: PCB/LPP_MainBoard_Gen_1_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
    [LPP_MainBoard_Gen_1_Ver_1.brd, LPP_MainBoard_Gen_1_Ver_1.dch, LPP_MainBoard_Gen_1_Ver_1.dip, LPP_MainBoard_Gen_1_Ver_1.sch, LPP_MainBoard_Gen_1_Ver_2.dch, LPP_MainBoard_Gen_1_Ver_2.dip]
2025-12-17 modified: LPP_STM32F103Cx/Core/Src/main.c renamed: PCB/LPP_MainBoard_Gen_1_Ver_2.dch -> PCB/LPP_MainBoard_Gen_1_Ver_3.dch renamed: PCB/LPP_MainBoard_Gen_1_Ver_2.dip -> PCB/LPP_MainBoard_Gen_1_Ver_3.d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
    [LPP_MainBoard_Gen_1_Ver_2.dch, LPP_MainBoard_Gen_1_Ver_2.dip, LPP_MainBoard_Gen_1_Ver_3.dch, LPP_MainBoard_Gen_1_Ver_3.dip]
2025-12-20 modified: BOOT_STM32F103Cx/Boot.ioc modified: LPP_SDK/lpp_sdk.c modified: LPP_SDK/lpp_sdk.h modified: LPP_STM32F103Cx/Core/Src/main.c modified: LPP_STM32F103Cx/MDK-ARM/JLinkLog.txt modified: LPP_STM3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
    [LPP_MainBoard_Gen_1_Ver_3.dch, LPP_MainBoard_Gen_1_Ver_3.dip]
2025-12-20 modified: LPP_SDK/lpp_sdk.c modified: LPP_SDK/lpp_sdk.h modified: LPP_STM32F103Cx/MDK-ARM/JLinkLog.txt modified: LPP_STM32F103Cx/MDK-ARM/LPP_STM32F103Cx.uvguix.user modified: LPP_STM32F103Cx/MDK-ARM/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
2026-01-11 deleted: BOOT_STM32F103Cx/.mxproject deleted: BOOT_STM32F103Cx/Boot.ioc deleted: BOOT_STM32F103Cx/Core/Inc/main.h deleted: BOOT_STM32F103Cx/Core/Inc/stm32f1xx_hal_conf.h deleted: BOOT_STM32F103Cx/Cor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
    [LPP_MainBoard_Gen_1_Ver_3.dch, LPP_MainBoard_Gen_1_Ver_3.dip, LPP_MainBoard_Gen_1_Ver_4.dch, LPP_MainBoard_Gen_1_Ver_4.dip]
2026-01-11 new file: LPP_STM32F103C8Tx/.mxproject new file: LPP_STM32F103C8Tx/Core/Inc/main.h new file: LPP_STM32F103C8Tx/Core/Inc/stm32f1xx_hal_conf.h new file: LPP_STM32F103C8Tx/Core/Inc/stm32f1xx_it.h new fi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
2026-01-11 new file: BOOT_STM32F103C8Tx/.mxproject new file: BOOT_STM32F103C8Tx/BOOT_STM32F103C8Tx.ioc new file: BOOT_STM32F103C8Tx/Core/Inc/main.h new file: BOOT_STM32F103C8Tx/Core/Inc/stm32f1xx_hal_conf.h new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
2026-01-11 modified: LPP_STM32F103C8Tx/MDK-ARM/LPP_STM32F103C8Tx.uvguix.user
2026-01-11 modified: LPP_STM32F103C8Tx/MDK-ARM/LPP_STM32F103C8Tx.uvguix.user modified: PCB/LPP_MainBoard_Gen_1_Ver_4.dip
    [LPP_MainBoard_Gen_1_Ver_4.dip]
2026-01-11 modified: PCB/LPP_MainBoard_Gen_1_Ver_4.dch modified: PCB/LPP_MainBoard_Gen_1_Ver_4.dip
    [LPP_MainBoard_Gen_1_Ver_4.dch, LPP_MainBoard_Gen_1_Ver_4.dip]
2026-01-12 modified: BOOT_STM32G431CBTx/MDK-ARM/BOOT_STM32G431CBTx.uvguix.user modified: LPP_SDK/lpp_sdk.c modified: LPP_STM32G431CBTx/MDK-ARM/LPP_STM32G431CBTx.uvguix.user modified: README.md
2026-01-12 new file: PCB/Backup_of___PINS.cdr new file: PCB/LPP_MainBoard_Jumper_Map.png modified: PCB/README.md
2026-01-12 deleted: PCB/STM32G431CBT6_Board_PIN.png
2026-01-15 modified: LPP_SDK/lpp_sdk.c modified: LPP_STM32G431CBTx/Core/Src/main.c modified: LPP_STM32G431CBTx/MDK-ARM/JLinkLog.txt modified: LPP_STM32G431CBTx/MDK-ARM/LPP_STM32G431CBTx.uvguix.user modified: LP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
2026-01-15 deleted: PCB/Backup_of_Backup_of_Backup_of___LPP_MainBoard_Jumper_Map.cdr deleted: PCB/Backup_of_Backup_of___LPP_MainBoard_Jumper_Map.cdr deleted: PCB/Backup_of___LPP_MainBoard_Jumper_Map.cdr
2026-02-21 modified: BOOT_STM32F103C8Tx/Core/Src/main.c modified: BOOT_STM32F103C8Tx/MDK-ARM/BOOT_STM32F103C8Tx.uvguix.user modified: BOOT_STM32F103C8Tx/MDK-ARM/BOOT_STM32F103C8Tx.uvoptx modified: BOOT_STM32F10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
2026-02-27 modified: BOOT_STM32F103C8Tx/MDK-ARM/BOOT_STM32F103C8Tx/BOOT_STM32F103C8Tx.htm modified: BOOT_STM32F103C8Tx/MDK-ARM/BOOT_STM32F103C8Tx/BOOT_STM32F103C8Tx.map modified: BOOT_STM32F411CEUx/MDK-ARM/BOOT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
2026-03-05 modified: LPP_STM32F103C8Tx/Core/Src/main.c modified: LPP_STM32F103C8Tx/MDK-ARM/LPP_STM32F103C8Tx.uvguix.user modified: LPP_STM32F103C8Tx/MDK-ARM/LPP_STM32F103C8Tx/LPP_STM32F103C8Tx.axf modified: LPP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
    [LPP_Carriage_Module_Gen_1 Ver_1.dip, LPP_Carriage_Module_Gen_1 Ver_2.dip, LPP_Carriage_Module_Gen_1_Ver_1.dch, LPP_Carriage_Module_Gen_1_Ver_2.dch, LPP_Carriage_Module_Gen_2_Ver_1.dch, LPP_Carriage_Module_Gen_2_Ver_1.dip, LPP_MainBoard_Gen_1_Ver_4.dch, LPP_MainBoard_Gen_1_Ver_4.dip]
2026-03-05 modified: PCB/README.md modified: README.md
2026-03-05 deleted: LPP_SDK/configs/lpp_config_g431_alt.h modified: PCB/README.md modified: README.md
2026-03-08 modified: PCB/LPP_MainBoard_Gen_1_Ver_5.dch modified: PCB/LPP_MainBoard_Gen_1_Ver_5.dip deleted: USB_HID_DEMO/HID2.cpp deleted: USB_HID_DEMO/README.md deleted: USB_HID_DEMO/main.c deleted: USB_HID_DE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
    [LPP_MainBoard_Gen_1_Ver_5.dch, LPP_MainBoard_Gen_1_Ver_5.dip]
2026-03-11 new file: PCB/Remove_R10_on_Bluepill.png
2026-03-11 modified: PCB/LPP_MainBoard_Gen_1_Ver_5.dch modified: PCB/LPP_MainBoard_Gen_1_Ver_5.dip
    [LPP_MainBoard_Gen_1_Ver_5.dch, LPP_MainBoard_Gen_1_Ver_5.dip]
2026-04-14 modified: BOOT_STM32F103C8Tx/MDK-ARM/BOOT_STM32F103C8Tx/BOOT_STM32F103C8Tx.axf modified: BOOT_STM32F103C8Tx/MDK-ARM/BOOT_STM32F103C8Tx/BOOT_STM32F103C8Tx.build_log.htm modified: BOOT_STM32F103C8Tx/MD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
2026-04-24 modified: LPP_SDK/lpp_sdk.c modified: LPP_STM32F103C8Tx/MDK-ARM/LPP_STM32F103C8Tx.uvguix.user modified: LPP_STM32F103C8Tx/MDK-ARM/LPP_STM32F103C8Tx.uvoptx modified: LPP_STM32F103C8Tx/MDK-ARM/LPP_STM3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
2026-05-21 new file: .vs/ARM_PROJECT/CopilotIndices/17.14.1641.39856/CodeChunks.db new file: .vs/ARM_PROJECT/CopilotIndices/17.14.1641.39856/SemanticSymbols.db new file: .vs/ARM_PROJECT/FileContentIndex/merges/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
2026-06-14 modified: LPP_SDK/lpp_core_gpio.c modified: LPP_SDK/lpp_sdk.c modified: LPP_SDK/lpp_sdk.h modified: LPP_STM32F103C8Tx/Core/Src/main.c new file: LPP_STM32F103C8Tx/Core/Src/main_F103.c modified: LPP_ST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
2026-06-21 modified: LPP_STM32F103C8Tx/Core/Src/main.c modified: LPP_STM32F103C8Tx/MDK-ARM/LPP_STM32F103C8Tx.uvguix.user modified: LPP_STM32F103C8Tx/MDK-ARM/LPP_STM32F103C8Tx/LPP_STM32F103C8Tx.axf modified: LPP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
2026-07-08 modified: LPP_STM32G431CBTx/MDK-ARM/LPP_STM32G431CBTx.uvguix.user modified: LPP_STM32G431CBTx/MDK-ARM/LPP_STM32G431CBTx.uvoptx modified: PCB/README.md
2026-10-01 Обновить README.md с новыми ссылками и схемой
    Добавлены быстрые ссылки и раздел о схеме подключения.
