DimaFantasy/LPP/(notices)

Notices in the files:
BOOT_STM32G431CBTx/Core/Src/main.c:
Copyright (c) 2025 STMicroelectronics.
All rights reserved.
This software is licensed under terms that can be found in the LICENSE file
LPP_SDK/lpp_sdk.c:
This program is free software: you can redistribute it and/or modify
it under the terms of the GNU General Public License as published by
the Free Software Foundation, either version 3 of the License, or
(at your option) any later version.
LPP_STM32F103C8Tx/Core/Src/main.c:
Copyright (c) 2023 STMicroelectronics.
